2549227674/stm32-ai-safety-monitor/CROSS_FILE_CONSISTENCY_REPORT.md

# 跨文件一致性自检报告

生成时间：2026-06-04T18:26:44

## 1. 自检结果

| 项目 | 结果 | 说明 |
|---|---|---|
| 项目主标题一致 | 通过 | 已在 README/CANONICAL/docs/14 等文件使用统一主标题。 |
| 四层架构一致 | 通过 | 四层名称来自 canonical。 |
| Contract 字段齐全 | 通过 | docs/07 为权威来源。 |
| 不新增 docs/15 | 通过 | 仅 docs/00-14 + docs/migration。 |
| 预期文件存在 | 通过 | 全部存在。 |
| TODO 索引生成 | 通过 | 共汇总 37 条 TODO。 |

## 2. 已修正/控制的冲突

- 旧仓库中文文件名在 zip 中出现 `#U...` 转义，本包统一使用 canonical 新文件名。
- 旧 STM32/ESP32 代码与最新会话状态脱节，本包在 migration 文档中写实说明，不把旧链路写成通过。
- Flask 后端不推倒重写，所有文档统一要求“保留并扩展”。
- `docs/07` 被指定为 Contract 权威来源，其他文档只引用，不另造字段。

## 3. 仍需本地执行的事项

详见 `CLAUDE_CODE_TODO_INDEX.md`。重点优先级：DECIDE/FILL 类先处理，随后执行 Task01–08。
