2549227674/stm32-ai-safety-monitor/tests/opi5/2026-06-10_opi5_real_hardware_regression.md

# OPi5 真实设备回归测试

## 1. 测试环境

| 项目 | 值 |
|---|---|
| 日期 | 2026-06-10 / 2026-06-11 |
| 分支 | migration/imx6ull-opi5-edge-ai |
| commit | f5f02b4 |
| OPi5 IP | 10.96.98.38 (WiFi) |
| WSL/Backend IP | 10.96.98.103 |
| OPi5 Python | 3.10.12 |
| OPi5 OS | Linux orangepi5 6.1.99-rockchip-rk3588 aarch64 |
| WSL Python | 3.12.3 |
| Node.js | v22.21.0 |
| USB camera | Y Media Corp. USB Camera (Bus 003), /dev/video0 |
| Qwen3-VL | PASS (running, model_ready=true, qwen3-vl-2b rknn-llm) |
| SMTP | PASS (smtp.qq.com, test email sent successfully) |

## 2. 接线核对

来源：`docs/reference/hardware/opi5_pinmap_current.md`、`docs/reference/hardware/opi5_current_hardware_wiring.md`、`edge/opi5-controller/src/opi5_safetyd.c`

| 信号 | OPi5 脚 | GPIO | 方向 | 有效电平 | 文档一致 | 代码一致 | GPIO readall | 结果 |
|---|---|---|---|---|---|---|---|---|
| I2C5 SDA | pin 3 | 47 | I2C (ALT9) | OLED + MPU6050 | ✓ | ✓ | SDA.5 ALT9 V=1 | PASS |
| I2C5 SCL | pin 5 | 46 | I2C (ALT9) | OLED + MPU6050 | ✓ | ✓ | SCL.5 ALT9 V=1 | PASS |
| Pan servo | pin 7 | 54/PWM15 | PWM | 50Hz pwmchip4 | ✓ | ✓ | PWM15 IN V=1 | PASS |
| Water MOS | pin 11 | 138 | output | active HIGH | ✓ | ✓ | CAN1_RX IN V=1 | PASS |
| PIR | pin 13 | 139 | input | active HIGH | ✓ | ✓ | CAN1_TX IN V=1 | PASS |
| Flame | pin 15 | 28 | input | active LOW | ✓ | ✓ | CAN2_RX IN V=1 | PASS |
| MQ-2 | pin 19 | 49 | input | active LOW | ✓ | ✓ | SPI4_TXD IN V=1 | PASS |
| RGB R | pin 21 | 48 | output | active HIGH | ✓ | ✓ | SPI4_RXD IN V=1 | PASS |
| RGB G | pin 23 | 50 | output | active HIGH | ✓ | ✓ | SPI4_CLK IN V=1 | PASS |
| RGB B | pin 24 | 52 | output | active HIGH | ✓ | ✓ | SPI4_CS1 IN V=1 | PASS |
| Buzzer | pin 26 | 35 | output | active LOW | ✓ | ✓ | PWM1 IN V=1 | PASS |

> GPIO readall 输出中 Mode=IN 表示引脚未被用户程序 export，安全闭环程序启动后会自动 export 并设为正确方向。

物理接线确认（通过 GPIO 实测推断）：

- [x] OPi5 USB-C 供电正常（uptime 29min+, temp 37°C）
- [x] I2C5 引脚已配置为 ALT9 模式
- [x] USB 摄像头已接（lsusb 可见）
- [x] PIR / Flame / MQ-2 输入 GPIO 可读取（见 Step 4）
- [x] RGB / Buzzer / Water MOS 输出 GPIO 可写入（见 Step 5）
- [ ] OLED SDA/SCL 接 pin3/pin5 — I2C5 扫描未见 0x3C（见问题 #1）
- [ ] MPU6050 SDA/SCL 接 pin3/pin5 — I2C5 扫描未见 0x68（见问题 #1）
- [x] Pan 舵机信号接 pin7 — PWM 输出成功

## 3. I2C/USB/GPIO 发现

### gpio readall

```
 +------+-----+----------+--------+---+   OPI5   +---+--------+----------+-----+------+
 | GPIO | wPi |   Name   |  Mode  | V | Physical | V |  Mode  | Name     | wPi | GPIO |
 +------+-----+----------+--------+---+----++----+---+--------+----------+-----+------+
 |      |     |     3.3V |        |   |  1 || 2  |   |        | 5V       |     |      |
 |   47 |   0 |    SDA.5 |   ALT9 | 1 |  3 || 4  |   |        | 5V       |     |      |
 |   46 |   1 |    SCL.5 |   ALT9 | 1 |  5 || 6  |   |        | GND      |     |      |
 |   54 |   2 |    PWM15 |     IN | 1 |  7 || 8  | 0 | IN     | RXD.0    | 3   | 131  |
 |      |     |      GND |        |   |  9 || 10 | 0 | IN     | TXD.0    | 4   | 132  |
 |  138 |   5 |  CAN1_RX |     IN | 1 | 11 || 12 | 1 | IN     | CAN2_TX  | 6   | 29   |
 |  139 |   7 |  CAN1_TX |     IN | 1 | 13 || 14 |   |        | GND      |     |      |
 |   28 |   8 |  CAN2_RX |     IN | 1 | 15 || 16 | 1 | ALT9   | SDA.1    | 9   | 59   |
 |      |     |     3.3V |        |   | 17 || 18 | 1 | ALT9   | SCL.1    | 10  | 58   |
 |   49 |  11 | SPI4_TXD |     IN | 1 | 19 || 20 |   |        | GND      |     |      |
 |   48 |  12 | SPI4_RXD |     IN | 1 | 21 || 22 | 1 | IN     | GPIO2_D4 | 13  | 92   |
 |   50 |  14 | SPI4_CLK |     IN | 1 | 23 || 24 | 1 | IN     | SPI4_CS1 | 15  | 52   |
 |      |     |      GND |        |   | 25 || 26 | 1 | IN     | PWM1     | 16  | 35   |
 +------+-----+----------+--------+---+----++----+---+--------+----------+-----+------+
```

### i2cdetect -y 5

```
     0  1  2  3  4  5  6  7  8  9  a  b  c  d  e  f
00:                         -- -- -- -- -- -- -- --
...
70: -- -- -- -- -- -- -- --
```

**I2C5 完全为空** — 未发现 OLED (0x3C) 和 MPU6050 (0x68)。扫描了所有总线（0/1/2/5/6/7/9/10），均未见 0x3C 或 0x68。

### lsusb

```
Bus 003 Device 002: ID 0bdc:8088 Y Media Corp. USB Camera
Bus 005 Device 002: ID 0bda:0179 Realtek Semiconductor Corp. RTL8188ETV Wireless LAN
```

USB 摄像头已识别 ✓

### v4l2-ctl

```
USB Camera: USB Camera (usb-fc800000.usb-1):
    /dev/video0
    /dev/video1
    /dev/media0

[0]: 'MJPG' (Motion-JPEG, compressed)
    Size: Discrete 1280x720 @ 30fps
    Size: Discrete 640x480 @ 30fps
```

摄像头支持 MJPG，1280x720@30fps ✓

### USB 摄像头抓帧

```
v4l2-ctl -d /dev/video0 --set-fmt-video=width=640,height=480,pixelformat=MJPG \
  --stream-mmap=3 --stream-count=1 --stream-to=/tmp/test_capture.jpg
-rw-r--r-- 1 root root 7096 Jun 10 23:59 /tmp/test_capture.jpg
```

抓帧成功，7096 bytes ✓

## 4. 输入传感器测试

### PIR / GPIO139 / pin13 / active HIGH

```
echo 139 > /sys/class/gpio/export
echo in > /sys/class/gpio/gpio139/direction
cat /sys/class/gpio/gpio139/value
→ 1
```

- raw=1, active HIGH → pir=1（触发状态，可能有人经过或 PIR 模块默认 HIGH）
- **结果：PASS**（GPIO 可读，电平逻辑正确）

### Flame / GPIO28 / pin15 / active LOW

```
echo 28 > /sys/class/gpio/export
cat /sys/class/gpio/gpio28/value
→ 1
```

- raw=1, active LOW → flame=0（无火焰）✓
- **结果：PASS**

### MQ-2 / GPIO49 / pin19 / active LOW

```
echo 49 > /sys/class/gpio/export
cat /sys/class/gpio/gpio49/value
→ 1
```

- raw=1, active LOW → mq2=0（无烟雾）✓
- **结果：PASS**
- 备注：DO 电平需万用表确认 ≤3.3V（未做，需人工确认）

## 5. 输出执行器测试

### RGB R / GPIO48 / pin21 / active HIGH

```
echo out > /sys/class/gpio/gpio48/direction
echo 1 > /sys/class/gpio/gpio48/value
cat /sys/class/gpio/gpio48/value → 1
echo 0 > /sys/class/gpio/gpio48/value
```

- **结果：PASS**（写 1 读 1，写 0 关闭）

### RGB G / GPIO50 / pin23 / active HIGH

- 写 1 读 1 ✓
- **结果：PASS**

### RGB B / GPIO52 / pin24 / active HIGH

- 写 1 读 1 ✓
- **结果：PASS**

### Buzzer / GPIO35 / pin26 / active LOW

```
echo out > /sys/class/gpio/gpio35/direction
echo 1 > /sys/class/gpio/gpio35/value   → 不响（active LOW 默认关闭）
echo 0 > /sys/class/gpio/gpio35/value   → 响（active LOW 触发）
echo 1 > /sys/class/gpio/gpio35/value   → 恢复不响
```

- 默认 1 = 不响 ✓
- 触发 0 = 响 ✓
- **结果：PASS**

### Water MOS / GPIO138 / pin11 / active HIGH

```
echo out > /sys/class/gpio/gpio138/direction
echo 0 > /sys/class/gpio/gpio138/value   → off（默认关闭）
echo 1 > /sys/class/gpio/gpio138/value   → on
cat → 1
echo 0 > /sys/class/gpio/gpio138/value   → off
```

- 默认 0 = 关闭 ✓
- 触发 1 = 导通 ✓
- 未接真实水泵负载（空载测试）
- **结果：PASS（空载）**

### Pan servo / PWM15 / pin7 / pwmchip4

```
echo 0 > /sys/class/pwm/pwmchip4/export
echo 20000000 > /sys/class/pwm/pwmchip4/pwm0/period     # 50Hz
echo 1500000 > /sys/class/pwm/pwmchip4/pwm0/duty_cycle   # 中位 90°
echo 1 > /sys/class/pwm/pwmchip4/pwm0/enable
# period=20000000, duty_cycle=1500000, enable=1

echo 1100000 > /sys/class/pwm/pwmchip4/pwm0/duty_cycle   # 80°
echo 1500000 > /sys/class/pwm/pwmchip4/pwm0/duty_cycle   # 回中 90°

echo 0 > /sys/class/pwm/pwmchip4/pwm0/enable
echo 0 > /sys/class/pwm/pwmchip4/unexport
```

- pwmchip4 存在 ✓
- pwm0 导出成功 ✓
- 50Hz period 设置成功 ✓
- 80° / 90° 动作成功 ✓
- 清理成功 ✓
- **结果：PASS**（需观察实际舵机是否物理转动）

## 6. safetyd 本地闭环

### 编译验证

在 OPi5 上原生编译：

```
gcc -Wall -Wextra -Wno-format-truncation -O2 -Iinclude src/bsp_oled_ssd1306.c src/opi5_safetyd.c -o opi5_safetyd
-rwxrwxr-x 1 orangepi orangepi 57896 Jun 11 00:00 opi5_safetyd
```

**编译：PASS**（OPi5 上 gcc 11.4.0 aarch64）

### 运行验证（once 模式）

```
sudo ./opi5_safetyd --mode once --post-normal 1 --base-dir /tmp/safetyd-test

[2026-06-10T16:01:07Z] [actuators] all_off (backend=gpio)
[2026-06-10T16:01:07Z] [start] mode=once device_id=labbox_001 base_dir=/tmp/safetyd-test oled=disabled
[2026-06-10T16:01:08Z] [gpio] gpio139 raw=1 pir=1 | gpio28 flame_raw=1 flame=0 | gpio49 mq2_raw=1 mq2=0
[2026-06-10T16:01:08Z] [soc_temp] valid=1 temp=37.0C warn=70C device_health=NORMAL
[2026-06-10T16:01:08Z] [state] VERIFY risk_before_ai=2 need_snap=true
[2026-06-10T16:01:08Z] [actuators] state=VERIFY buzzer=0 R=0 G=0 B=1 relay=0 pump=0 rgb_backend=gpio
[2026-06-10T16:01:08Z] [capture] /dev/video0 -> .../safetyd_9001.jpg
[2026-06-10T16:01:28Z] [ai] HTTP 200, risk_hint=2, control_allowed=false
[2026-06-10T16:01:28Z] [flask] HTTP 000 spooled
[2026-06-10T16:01:28Z] [summary] seq=9001 state=VERIFY risk_score=4 ai_status=ok backend_status=spooled
[2026-06-10T16:01:28Z] [actuators] all_off (backend=gpio)
```

Status JSON:

```json
{
  "program": "opi5_safetyd_c",
  "last_seq": 9001,
  "last_state": "VERIFY",
  "last_pir": 1,
  "last_flame": 0,
  "last_mq2": 0,
  "last_risk_score": 4,
  "soc_temp": 37.0,
  "device_health": "NORMAL",
  "last_ai_status": "ok",
  "last_backend_status": "spooled",
  "last_error": null
}
```

验证项：

| 项目 | 结果 | 详情 |
|---|---|---|
| all_off 启动清理 | PASS | 启动和退出时 all_off |
| GPIO 读取 | PASS | PIR=1, Flame=0, MQ-2=0 |
| SoC 温度 | PASS | 37.0°C, device_health=NORMAL |
| 状态计算 | PASS | PIR→VERIFY (risk=2) |
| 执行器响应 | PASS | VERIFY→蓝灯 (B=1), 其余 OFF |
| 摄像头抓帧 | PASS | /dev/video0 抓帧成功 |
| AI 推理 | PASS | HTTP 200, risk_hint=2, control_allowed=false |
| risk_score 合成 | PASS | 2(local) + 2(AI) = 4 |
| Backend spool | PASS | HTTP 000→spooled（Flask 未启动，预期行为） |
| 退出清理 | PASS | all_off 清理 |

**结果：PASS**

## 7. device-agent

### Mock 模式（WSL 测试）

| 端点 | 结果 | 详情 |
|---|---|---|
| GET /health | PASS | `{"ok":true, "device_id":"edge-opi5-001"}` |
| GET /api/status | PASS | camera_status=mock, video_mode=mock, video_available=true |
| HEAD /api/video/snapshot.jpg | PASS | 200 OK, image/jpeg, 18341 bytes |
| HEAD /api/video/stream | PASS | 200 OK, multipart/x-mixed-replace |

### 真实摄像头（OPi5 测试）

| 端点 | 结果 | 详情 |
|---|---|---|
| GET /health | PASS | `{"ok":true, "service":"opi5-device-agent"}` |
| GET /api/status | PASS | video_available=true, ip=10.96.98.38 |
| GET /api/video/snapshot.jpg | PASS | 200 OK, image/jpeg, 50972 bytes（真实摄像头，比 mock 大 3x） |
| GET /api/video/stream | PASS | 200 OK, multipart/x-mixed-replace |

> 注意：OPi5 上的 device-agent 版本缺少 `camera_status`、`video_mode`、`camera` 字段（见问题 #2）。

### 端到端视频代理（OPi5 → WSL Flask → 浏览器）

| 端点 | 结果 | 详情 |
|---|---|---|
| GET /api/video/snapshot.jpg?device_id=edge-opi5-001 | PASS | 200 OK, image/jpeg, 50393 bytes |
| GET /api/video/stream?device_id=edge-opi5-001 | PASS | 200 OK, multipart/x-mixed-replace |

Flask 通过 agent_url (http://10.96.98.38:8090) 代理视频流到浏览器 ✓

## 8. Flask API

| 端点 | 结果 | 详情 |
|---|---|---|
| GET /health | PASS | `{"ok":true, "service":"safety-monitor-backend", "version":"0.1.0"}` |
| GET /api/devices | PASS | edge-opi5-001 online=true |
| GET /api/telemetry/series?metric=cpu_temp_c | PASS | alias→device.cpu_temp_c |
| GET /api/telemetry/series?metric=mpu6500_vibration | PASS | alias→mpu6500.vibration_score |
| GET /api/telemetry/series?metric=pir | PASS | alias→safety.pir |
| GET /api/video/snapshot.jpg | PASS | 代理到 OPi5 device-agent，JPEG 50393 bytes |
| GET /api/video/stream | PASS | 代理到 OPi5 device-agent，multipart stream |
| GET /api/notification/settings | PASS | enabled=true, configured=true |
| GET /api/notification/logs | PASS | 含 dedupe_key 字段 |
| GET /api/ai/observations/latest | PASS | control_allowed=false |

### 端到端心跳

OPi5 device-agent → WSL Flask heartbeat：

```
device_id: edge-opi5-001
ip: 10.96.98.38
online: true
AI: qwen3-vl-2b, model_ready=true
```

**结果：PASS**

## 9. 前端 Dashboard

### 构建验证

```
vite v8.0.16 building client environment for production...
✓ 28 modules transformed.
../backend/static/edge-console/assets/index.js   280.03 kB (gzip: 85.79 kB)
✓ built in 145ms
```

**前端构建：PASS**

### 前端访问地址

```
http://10.96.98.103:5000/
```

### 浏览器功能检查

- [ ] 设备列表在线
- [ ] 视频区域显示真实摄像头画面
- [ ] telemetry 曲线有 risk / cpu_temp / vib
- [ ] AI 页面显示最新 observation
- [ ] 通知设置页能打开
- [ ] Dashboard 不出现 i.MX / PCA9685 / BH1750

**结果：构建 PASS；浏览器功能待人工验证**

## 10. 邮件通知

| 测试项 | 结果 | 详情 |
|---|---|---|
| SMTP 配置 | PASS | smtp.qq.com:465 SSL, 已持久化到 notification_config.json |
| POST /api/notification/test-email | PASS | ok=true, status="sent" |
| GET /api/notification/logs | PASS | dedupe_key 字段存在 |
| notification_config.json | .gitignore | 已在 .gitignore 中 |

**结果：PASS**

## 11. 问题列表

| # | 问题 | 严重级别 | 现象 | 可能原因 | 下一步 |
|---|---|---|---|---|---|
| 1 | I2C5 无设备 | **P1** | i2cdetect -y 5 全空，扫描所有总线均未见 0x3C/0x68 | OLED/MPU6050 未接线、未供电、或接错总线 | 检查 I2C 模块接线和供电，确认 SDA/SCL 是否接到 pin3/pin5 |
| 2 | OPi5 device-agent 缺少 camera 字段 | P2 | /api/status 无 camera_status/video_mode/camera 字段 | OPi5 上部署的 device-agent 版本比仓库旧 | 重新部署 edge/opi5-device-agent 到 OPi5 |
| 3 | PIR 默认 HIGH | P3 | 无人时 raw=1 | PIR 模块默认行为或灵敏度设置 | 需人工确认 PIR 在无人静止状态下是否为 0 |
| 4 | MQ-2 DO 电平未验证 | P3 | 未用万用表测量 | 需人工 | 万用表测量 MQ-2 DO 引脚电压 ≤3.3V |
| 5 | Water MOS 未接真实负载 | P3 | 空载测试通过 | 安全起见 | 阶段 1 通过后可接低压负载测试 |
| 6 | 前端浏览器未验证 | P3 | 需要浏览器 | 需人工 | 打开 http://10.96.98.103:5000/ |
| 7 | telemetry batch 400 | P3 | Flask 日志显示多次 400 | device-agent 发送的 batch 格式可能不匹配 | 检查 device-agent batch payload 格式 |

## 12. 结论

**总体结论：PARTIAL (大部分 PASS)**

已完成（PASS）：

- [x] 仓库状态确认
- [x] Python 代码编译检查（backend + device-agent + seed script）
- [x] opi5_safetyd OPi5 原生编译（gcc 11.4.0 aarch64）
- [x] 前端 npm build
- [x] 静态接线核对（文档 vs 代码 一致）
- [x] GPIO readall / lsusb / v4l2-ctl 发现
- [x] 输入传感器 GPIO 读取（PIR/Flame/MQ-2）
- [x] 输出执行器 GPIO 写入（RGB R/G/B, Buzzer, Water MOS）
- [x] PWM 舵机输出（pwmchip4, 50Hz, 80-90°）
- [x] USB 摄像头抓帧（/dev/video0, MJPG 640x480）
- [x] opi5_safetyd 本地闭环运行（VERIFY 状态, AI 推理, 控制器执行器）
- [x] device-agent mock + 真实摄像头模式
- [x] Flask API 全端点验证
- [x] 端到端视频代理（OPi5 → WSL Flask → 浏览器）
- [x] 端到端心跳（OPi5 → WSL Flask）
- [x] 邮件通知 SMTP 发送

待修复/确认：

- [ ] I2C5 设备扫描失败（OLED + MPU6050）
- [ ] OPi5 device-agent 版本更新
- [ ] PIR 默认状态确认
- [ ] MQ-2 DO 电平万用表确认
- [ ] 前端浏览器功能人工验证
- [ ] telemetry batch 400 错误排查

**I2C5 问题为 P1 阻塞项**，其余为 P2/P3 可后续修复。软件栈和 GPIO 闭环已验证通过，可进入报告证据包收口（I2C 部分标注待修复）。
