2549227674/stm32-ai-safety-monitor/CLAUDE_CODE_TASK_02_wsl_imx6ull_toolchain_ssh.md

# Archived

This task belongs to the historical i.MX6ULL stage and is no longer part of the current OPi5 demo mainline.

Current entry: see `CLAUDE_CODE_TASK_DOCS_OPI5_ALIGNMENT.md` and `CANONICAL_DECISIONS.md`.
Archive: `docs/archive/2026-imx6ull-stage/tasks/CLAUDE_CODE_TASK_02_wsl_imx6ull_toolchain_ssh.md`
