2549227674/stm32-ai-safety-monitor/docs/03_硬件系统设计与供电安全_OPi5版.md

# 03 硬件系统设计与供电安全（OPi5 版）

## 3.1 当前硬件口径

OPi5 是唯一主控。图 1 为 OPi5 26pin 接口 + 供电拓扑，图 2 为 OPi5 引脚到模块的实际接线。

当前正式接线不包含：i.MX6ULL、STM32、ESP32-CAM、PCA9685、Tilt 舵机、继电器、风扇、P1 水泵。

## 3.2 当前模块清单

| 模块 | 用途 | 状态 |
|---|---|---|
| Orange Pi 5 16GB + 128G NVMe | 主控 + AI 推理 | 当前主线 |
| USB 摄像头 | 图像采集 | 当前主线 |
| PIR 人体红外 | 运动检测 | 当前主线 |
| 火焰传感器 | 火焰检测 | 当前主线 |
| MQ-2 烟雾传感器 | 烟雾/气体检测 | 当前主线 |
| RGB LED + 220Ω | 状态指示灯 | 当前主线 |
| 有源蜂鸣器 + NPN | 声音报警 | 当前主线 |
| Water MOS 模块 | 低压喷淋开关 | 当前主线 |
| MG90 单轴 Pan 舵机 | 摄像头水平扫描 | 当前主线 |
| OLED SSD1306 0.96" | 本地状态屏 | 当前主线 |
| MPU6050 | 可选振动监测 | 当前主线 |
| DHT11 | 未来外置 MCU 预留 / mock | 仅 mock |

## 3.3 OPi5 26pin 引脚分配

```text
I2C1 SDA       pin16 gpio59   OLED 0x3C + MPU6050 0x68
I2C1 SCL       pin18 gpio58   OLED 0x3C + MPU6050 0x68
Pan servo      pin7  gpio54/PWM15
Water MOS      pin11 gpio138 active HIGH
PIR            pin13 gpio139 active HIGH
Flame          pin15 gpio28  active LOW
MQ-2           pin19 gpio49  active LOW
RGB-R          pin21 gpio48  active HIGH
RGB-G          pin23 gpio50  active HIGH
RGB-B          pin24 gpio52  active HIGH
Buzzer         pin26 gpio35  active LOW
```

## 3.4 供电拓扑与 GND_STAR

```text
12V 输入（适配器/电池）
  ├─ DC-DC 5V/4A~5A  → OPi5 USB-C
  ├─ DC-DC 5V~6V/3A  → 舵机 5V（独立供电）
  ├─ 负载 5V          → Water MOS 负载
  └─ GND 星形共地     → OPi5 / MOS / 负载 / 传感器
```

- 传感器供电：3.3V 从 OPi5 引脚取
- 舵机供电：独立 5V~6V DC-DC，不从 OPi5 取
- MOS 负载：独立 5V，不从 OPi5 取
- 所有模块共地，星形拓扑

## 3.5 输入传感器

| 信号 | 引脚 | 有效电平 | 供电 | 说明 |
|---|---|---|---|---|
| PIR | pin13 / gpio139 | active HIGH | 3.3V（模块自带） | 人体红外 |
| Flame | pin15 / gpio28 | active LOW | 3.3V | 火焰数字 DO |
| MQ-2 | pin19 / gpio49 | active LOW | 5V（加热丝） | 烟雾数字 DO |

> MQ-2 供电 5V，DO 输出经分压或直接接入 OPi5 GPIO（OPi5 GPIO 为 3.3V tolerant，MQ-2 模块 DO 输出通常为 3.3V 逻辑电平）。

## 3.6 I2C 设备

| 设备 | 地址 | 总线 | 说明 |
|---|---|---|---|
| OLED SSD1306 | 0x3C | I2C1 (pin16/pin18) | 状态屏 |
| MPU6050 | 0x68 | I2C1 (pin16/pin18) | 可选振动监测 |

## 3.7 输出设备

| 输出 | 引脚 | 驱动 | 有效电平 | 默认态 |
|---|---|---|---|---|
| RGB-R | pin21 / gpio48 | GPIO + 220Ω 限流 | active HIGH | OFF |
| RGB-G | pin23 / gpio50 | GPIO + 220Ω 限流 | active HIGH | OFF |
| RGB-B | pin24 / gpio52 | GPIO + 220Ω 限流 | active HIGH | OFF |
| Buzzer | pin26 / gpio35 | NPN 三极管 + 1k 基极 | active LOW | OFF (gpio=1) |
| Water MOS | pin11 / gpio138 | MOS 模块 | active HIGH | OFF |
| Pan servo | pin7 / PWM15 | PWM 50Hz | 脉宽控制 | 90° 中位 |

## 3.8 摄像头

USB 摄像头接入 OPi5 USB 口。由 `opi5-device-agent` 提供 MJPEG 视频流（`/api/video/stream`）和快照（`/api/video/snapshot.jpg`）。摄像头不可用时 device-agent 自动回退到 mock 模式。

## 3.9 不再使用的模块

以下模块属于历史阶段，不在当前 OPi5 主线接线中：

| 模块 | 历史阶段 | 说明 |
|---|---|---|
| i.MX6ULL Pro | 第二版双板架构 | 供电/启动异常，已迁移 |
| STM32 + ESP32-CAM | 第一版端云架构 | 已归档 |
| PCA9685 16路 PWM | 第二版 i.MX 控制 | 4 个模块均未 ACK，已弃用 |
| Tilt 舵机 | 第二版二维云台 | 当前仅用单轴 Pan |
| 继电器模块 | 第二版 P1 扩展 | 不在当前接线 |
| 风扇 | 第二版 P1 扩展 | 不在当前接线 |
| P1 水泵 | 第二版 P1 扩展 | 当前用 Water MOS 替代 |

## 3.10 安全边界

1. 低压直流供电，不接 220V
2. 星形共地，避免地环路
3. 执行器上电默认 OFF
4. AI 服务 / Flask / 前端不控制执行器；只有 OPi5 本地 `opi5_safetyd` 控制执行器
5. `control_allowed=false` 硬编码
