2549227674/stm32-ai-safety-monitor/docs/11_测试计划与风险矩阵_端边协同版.md

# 11 测试计划与风险矩阵（OPi5 主线版）

## 11.1 测试原则

1. 先单模块，后集成。
2. 先空载，后接负载。
3. 先 mock，后真实。
4. 未实测不写通过。
5. 每项测试都要有命令、现象、结果、证据路径。

## 11.2 编译与语法检查

| 测试 | 命令 | 说明 |
|---|---|---|
| backend py_compile | `python -m py_compile server/backend/*.py` | Flask 后端语法 |
| device-agent py_compile | `python -m py_compile edge/opi5-device-agent/*.py` | 设备代理语法 |
| seed script | `python -m py_compile scripts/seed_frontend_mock_data.py` | mock 数据脚本语法 |
| frontend build | `cd server/frontend && npm run build` | React 构建 |

## 11.3 Flask API 测试

| 测试 | 方法 | 说明 |
|---|---|---|
| `/health` | `curl` | 服务健康检查 |
| `POST /api/events` | `curl` | 旧事件兼容 |
| `GET /api/events` | `curl` | 事件列表 |
| `GET /api/status/latest` | `curl` | 最新状态 |
| `POST /api/devices/heartbeat` | `curl` | 设备心跳 |
| `GET /api/devices` | `curl` | 设备列表 |
| `POST /api/telemetry/batch` | `curl` | 遥测批量上报 |
| `GET /api/telemetry/series` | `curl` | 遥测时序查询 |
| `POST /api/ai/observations` | `curl` | AI observation |
| `GET /api/ai/observations/latest` | `curl` | 最新 AI observation |
| `GET/PUT /api/notification/settings` | `curl` | 通知配置 |
| `POST /api/notification/test-email` | `curl` | 测试邮件 |
| `GET /api/notification/logs` | `curl` | 通知日志 |

## 11.4 mock 数据与 seed 脚本

| 测试 | 方法 | 说明 |
|---|---|---|
| seed mock 数据 | `python scripts/seed_frontend_mock_data.py` | 向 Flask 注入 mock 事件/遥测/AI |
| no-device 状态 | 不发送心跳 | Dashboard 显示设备离线 |
| mock 视频 | device-agent `MOCK_SENSORS=1` | 视频流标注 MOCK |

## 11.5 前端构建与展示

| 测试 | 方法 | 说明 |
|---|---|---|
| npm build | `npm run build` | 构建无报错 |
| Dashboard 可访问 | 浏览器打开 | 多页面可导航 |
| 设备离线状态 | 不启动 device-agent | Dashboard 显示无设备 |
| mock 数据展示 | seed 后刷新 | 事件/遥测/AI 数据可见 |

## 11.6 device-agent 测试

| 测试 | 方法 | 说明 |
|---|---|---|
| `/health` | `curl` | 服务健康 |
| `/api/status` | `curl` | 设备状态 |
| `/api/video/stream` | `curl` / 浏览器 | MJPEG 流（mock） |
| `/api/video/snapshot.jpg` | `curl` | 快照（mock） |
| 心跳上报 | 观察 Flask `/api/devices` | 5s 周期 |
| 遥测上报 | 观察 Flask `/api/telemetry/series` | 30s 批量 |
| AI observation | 观察 Flask `/api/ai/observations` | 30s 周期 |

## 11.7 通知测试

| 测试 | 方法 | 说明 |
|---|---|---|
| 通知配置持久化 | PUT settings 后重启 | 配置保留 |
| 测试邮件 | POST test-email | 实际发送 |
| 通知日志 | GET logs | 记录可见 |

## 11.8 视频代理测试

| 测试 | 方法 | 说明 |
|---|---|---|
| mock 视频代理 | Flask `/api/video/stream` | 返回 mock 流 |
| 设备离线 503 | 不启动 device-agent | Flask 返回 503 |
| 快照代理 | Flask `/api/video/snapshot.jpg` | 返回 JPEG |

## 11.9 真实硬件测试（仅当硬件可用时）

| 测试 | 方法 | 说明 |
|---|---|---|
| PIR 触发 | 人体靠近 | pir=1，状态变化 |
| 火焰触发 | 打火机靠近 | flame=1 → ALARM |
| MQ-2 触发 | 烟雾靠近 | mq2=1 → ALARM |
| 蜂鸣器响应 | ALARM 状态 | 蜂鸣器响 |
| RGB 状态灯 | 各状态 | 颜色正确 |
| Water MOS | ALARM 状态 | MOS 导通 |
| Pan 舵机 | 巡检扫描 | 三点平滑 |
| USB 摄像头 | 真实视频流 | MJPEG 正常 |
| AI 推理 | Qwen3-VL | 返回真实结果 |

## 11.10 风险矩阵

| 风险 | 概率 | 影响 | 应对 |
|---|---|---|---|
| 摄像头不兼容 | 中 | 中 | mock 回退，降低分辨率 |
| AI 模型加载慢 | 中 | 低 | 持久化进程，启动预热 |
| 供电不稳 | 中 | 高 | 多路 DC-DC，舵机独立供电 |
| Dashboard schema 破坏 | 低 | 中 | `raw_json` 兼容，增量迁移 |
| email 配置失效 | 低 | 低 | mock 通知日志回退 |

## 11.11 答辩前检查清单

- [ ] Dashboard 可打开，多页面可导航
- [ ] 至少一条 mock 事件可展示
- [ ] 至少一个 AI observation 可展示
- [ ] 通知设置可配置，测试邮件可发送
- [ ] AI JSON 中 `control_allowed=false`
- [ ] 设备离线状态可展示
- [ ] mock/真实模式切换正常

## 11.12 历史 i.MX 测试索引

历史 i.MX6ULL 阶段的测试记录保留在 `tests/imx6ull/` 和 `tests/integration/` 中，包括 GPIO 输入、PCA9685 PWM、V4L2 抓拍、端边联调等。详见 `docs/archive/2026-imx6ull-stage/`。
