2549227674/stm32-ai-safety-monitor/legacy/2026-stm32-esp32/stm32/README.md

# STM32 固件开发说明

## 开发环境

- MCU：STM32F103C8T6
- 工具链：STM32CubeMX + Keil MDK-ARM
- 固件库：STM32 HAL 库
- 调试下载：ST-Link
- 调度方式：裸机前后台 + SysTick 定时调度

不使用 STM32F10x 标准外设库，不混用标准库和 HAL，不引入 FreeRTOS。CubeMX 生成文件中的自定义代码必须写在 `USER CODE BEGIN` / `USER CODE END` 区域。

`.c/.h` 源码注释建议使用英文，避免 Keil 中文注释显示为 `???`；README 和 docs 文档继续使用中文。

## 当前真实进度

| 编号 | 任务 | 状态 | 备注 |
|---|---|---|---|
| P0-00 | STM32 最小工程 + PC13 LED 闪烁 | 已完成 | CubeMX + Keil + HAL + ST-Link 跑通；HSE 8MHz + PLL x9，SYSCLK 72MHz；PA13/PA14 保留 SWD |
| P0-01 | USART1 串口日志输出 | 暂缓 | USB-TTL 未到货；计划使用 PA9/PA10；当前依赖 PC13 LED 和 Keil Debug Watch |
| P0-02 | AD 四位按键输入验证 | 已完成 | AD 接 PA0/ADC1_IN0；ADC1 软件触发、单通道、轮询读取；K1-K4 阈值已实测 |
| P0-03 | 蜂鸣器 / RGB LED 输出验证 | 已完成 | PB5 蜂鸣器低电平触发；PB0/PB1/PB10 分别控制 RGB R/G/B |
| P0-04A-1 | OLED 固定文本显示 | 已完成 | I2C1 PB6/PB7，地址 0x3C |
| P0-04A-2 | OLED 实时调试页面 | 已完成 | 显示 KEY ADC、KEY ID、FLAME、PIR、MQ2、STATE |
| P0-04B-0 | 火焰传感器 DO 输入 | 部分完成 | PB12 / FLAME_DO；无火焰状态显示正常，真实触发待安全补测 |
| P0-04B-1 | PIR HC-SR501 输入 | 已完成 | PB15 / PIR_DO 已通过；PB13 原方案输入链路不可靠，不再作为 PIR 默认引脚 |
| P0-04B-2 | MQ-2 DO 输入 | 软件链路通过，实物暂缓 | PB14 / MQ2_DO 模拟通过；MQ-2 实物 DO/AO 待 10k/20k 分压电阻 |
| P0-04B-3 | MQ-2 AO 输入 | 未开始 | 后续 PA1 / ADC1_IN1；5V 供电时必须分压 |
| P0-05 | 继电器 / 风扇 / 水泵低压驱动 | 未开始 | 需外部电源和 MOS/驱动模块 |
| P0-06 | risk_score 风险评分 | 未开始 | 待输入输出链路稳定后实现 |
| P0-07 | safety_fsm 状态机 | 未开始 | 待 risk_score |
| P0-08 | 按键功能映射 | 未开始 | P0-02 仅完成 AD 按键识别 |
| P0-09 | P0 本地闭环整体验收 | 未开始 | 不依赖 ESP32-CAM/Web/服务器/AI |
| Stage 5 / Task 04 | USART1 → ESP32-CAM UART 桥接 | 代码已准备，待联调 | PA9=USART1_TX、PA10=USART1_RX，115200 8N1；当前只发送固定 `STM32_TEST` JSON；PA2/USART2 因逻辑分析仪未得到稳定 UART 波形，阶段 5 暂时放弃 |

当前 P0 阶段使用面包板分配 3.3V/5V 分轨并统一共地。ST-Link 3.3V 只适合 STM32 和少量小功耗模块临时 bring-up；MQ-2、ESP32-CAM、继电器、风扇、水泵不得从 ST-Link 3.3V 取电。若 STM32 已由手机 Type-C 充电器经核心板 Type-C 供电，则 ST-Link 只接 SWDIO/SWCLK/GND，不接 ST-Link 3.3V。12V 适配器/电池不得直接接 STM32、OLED、PIR、MQ-2。

## 当前 P0 OLED 模块

已新增：

```text
Core/Inc/bsp_oled.h
Core/Src/bsp_oled.c
Core/Inc/app_display.h
Core/Src/app_display.c
```

`bsp_oled` 是 SSD1306 OLED BSP 驱动，负责初始化、清屏、写字符、写字符串、刷新显示；使用 `I2C1`，`PB6=SCL`，`PB7=SDA`，地址 `0x3C`。

`app_display` 是 P0 调试显示页面，负责显示 `KEY ADC`、`KEY ID`、`FLAME`、`PIR`、`MQ2`、`STATE`。它不直接读取传感器，不直接控制执行器。

## Stage 5 / Task 04 UART 桥接代码

当前新增：

```text
Core/Inc/app_comm.h
Core/Src/app_comm.c
```

`app_comm` 只负责组装固定 `STM32_TEST` 事件 JSON，并通过 `USART1` 发送给 ESP32-CAM。每帧以 `\n` 结尾，第一版不读取 GPIO、不控制执行器、不实现 `risk_score` 或 `safety_fsm`，也不启用 DHT11。

USART1 配置由用户通过 CubeMX 生成：

```text
PA9  = USART1_TX
PA10 = USART1_RX
115200 8N1
```

PA2/USART2 在逻辑分析仪上未得到稳定 115200 UART 波形，阶段 5 暂时放弃。`main.c` 当前每 1 秒调用一次 `AppComm_SendStm32Test()`。Keil 编译前需要确认工程中已加入 `Core/Src/app_comm.c`。

最小接线：

```text
STM32 PA9 / USART1_TX -> ESP32-CAM U0R / RX / GPIO3
STM32 GND             <-> ESP32-CAM GND
ESP32-CAM 继续使用 USB 烧录底座供电
```

不要用 STM32 3.3V 或 ST-Link 3.3V 给 ESP32-CAM 供电。

当前 OLED 显示页面大致为：

```text
Safety Monitor
P0 Debug Page

KEY ADC:xxxx
KEY ID :NONE/K1/K2/K3/K4
FLAME  :0/1
PIR:0 MQ2:0
STATE  :IDLE/PIR/SMOKE/ALARM
```

## CubeMX 建工程步骤

1. 新建 CubeMX 工程，选择 `STM32F103C8T6`。
2. 配置系统时钟，优先使用 HSE；无外部晶振时使用 HSI。
3. `SYS` 调试接口选择 `Serial Wire`。
4. 配置 LED GPIO 为推挽输出。
5. 配置按键、门磁、PIR、火焰等 GPIO 输入，并设置 Pull-up 或 Pull-down，禁止浮空。
6. 配置 USART1 作为调试串口。
7. 配置 I2C 用于 OLED 和 MPU6050。
8. 配置 ADC 用于 MQ-2 AO。
9. 配置 TIM/PWM 用于蜂鸣器、RGB、风扇等输出。
10. Project Manager 中选择 Keil MDK-ARM 工程。
11. 生成代码后，只在 `USER CODE BEGIN` / `USER CODE END` 区域添加自定义代码。
12. 在 Keil 中编译、下载，先验证 LED 闪烁；USART1 日志待 USB-TTL 到货后补测。

引脚分配以 `docs/03_硬件系统设计与供电安全.md` 和 `firmware/stm32/docs/pinmap.md` 为准。本文件只记录阶段进度。

## 目录约定

- `Core/`：CubeMX 生成的启动、初始化和主文件。
- `BSP/`：对 HAL 外设接口做项目级封装，如 GPIO、ADC、I2C、USART、TIM/PWM。
- `Drivers/`：OLED、DHT、MQ-2、MPU6050、蜂鸣器、RGB 等设备驱动。
- `App/`：任务调度、传感器管理、风险评分、状态机、执行器联动、UI 和日志。
- `Protocol/`：STM32 与 ESP32-CAM 的 UART 帧协议。
- `Config/`：阈值、周期、引脚映射和功能开关。

## P0 最小验证顺序

1. LED：验证工程、时钟、HAL Tick 和主循环。已完成。
2. 串口：输出启动日志和周期心跳。暂缓，待 USB-TTL 到货。
3. 按键：AD 四位按键接 PA0/ADC1_IN0，验证短按和消抖。已完成输入识别。
4. 蜂鸣器/RGB：验证 PB5、PB0、PB1、PB10 输出。已完成。
5. OLED：已提前到 P0-04A，完成固定文本和实时调试页面。
6. 传感器：火焰 PB12 无火焰状态正常、PIR PB15 已通过、MQ-2 DO PB14 软件链路通过；MQ-2 实物和 AO 待分压电阻。
7. 执行器：P0-05 进入继电器/风扇/水泵低压驱动验证。
8. 状态机：后续接入风险评分、报警分级、声光和执行器联动。

## GPIO 输入要求

所有 GPIO 输入必须配置明确的 Pull-up 或 Pull-down，不能浮空。外部模块已带上拉/下拉时仍需在文档或代码注释中注明，避免误判输入电平。
