2549227674/stm32-ai-safety-monitor/docs/archive/2026-imx6ull-stage/hardware/README.md

# i.MX6ULL Stage - Hardware Archive

This directory originally contained i.MX6ULL hardware references.

## Current Hardware References

The current OPi5 hardware documentation is in:
- `docs/03_硬件系统设计与供电安全_OPi5版.md` — OPi5 wiring and power design
- `docs/reference/hardware/opi5_current_hardware_wiring.md` — OPi5 wiring diagram
- `docs/reference/hardware/opi5_pinmap_current.md` — OPi5 pinmap

## Historical i.MX6ULL Hardware

The i.MX6ULL hardware design is preserved in git history. Key references:
- i.MX6ULL J5 GPIO pinout (gpio117-124)
- PCA9685 I2C PWM (CH0-CH6)
- V4L2 USB camera on i.MX6ULL USB Host
- Dual-board network topology (i.MX6ULL ↔ OPi5)

See `docs/archive/2026-imx6ull-stage/tasks/` for the original task files with hardware details.
