2549227674/stm32-ai-safety-monitor/legacy/2026-stm32-esp32/stm32/docs/pinmap.md

# STM32 Pin Map

本文档记录当前已验证和预留引脚。未实际验证的引脚必须标注为“预留”或“待验证”，避免后续误认为已经完成。

## 已验证 / 部分验证引脚

| 引脚 | 功能 | 状态 | 说明 |
|---|---|---|---|
| PA13 | SWDIO | 已验证 / 保留 | ST-Link 下载调试，必须保留 |
| PA14 | SWCLK | 已验证 / 保留 | ST-Link 下载调试，必须保留 |
| PC13 | 板载 LED | 已验证 | 低电平点亮，用于 P0 心跳闪烁 |
| PA0 | ADC1_IN0 | 已验证 | AD 四位按键模块，VCC 接 3.3V，GND 接 GND，AD 接 PA0 |
| PB5 | Buzzer | 已验证 | 有源蜂鸣器低电平触发：RESET 响，SET 不响 |
| PB0 | RGB_R | 已验证 | KY-016 RGB 红色通道 |
| PB1 | RGB_G | 已验证 | KY-016 RGB 绿色通道 |
| PB10 | RGB_B | 已验证 | KY-016 RGB 蓝色通道 |
| PB6 | I2C1_SCL / OLED | 已验证 | SSD1306 OLED，地址 0x3C |
| PB7 | I2C1_SDA / OLED | 已验证 | SSD1306 OLED，地址 0x3C |
| PB12 | FLAME_DO | 部分验证 | 3 针火焰传感器 DO；无火焰状态显示正常，真实触发待安全补测 |
| PB14 | MQ2_DO | 软件链路通过 | FT 数字输入；实物 DO 接入前需确认高电平不超过 5V，且 GPIO 输入禁用内部上下拉 |
| PB15 | PIR_DO | 已验证 | HC-SR501 OUT；PB15 最终方案通过 |

## 预留 / 待验证引脚

| 引脚 | 计划功能 | 状态 | 说明 |
|---|---|---|---|
| PA9 | USART1_TX | 已配置 / 待联调 | Stage 5 / Task 04：STM32 发送 `STM32_TEST` JSON 到 ESP32-CAM U0R/RX/GPIO3；尚未完成硬件联调验收 |
| PA10 | USART1_RX | 已配置 / 待联调 | Stage 5 / Task 04：USART1 RX 预留，当前主要验证 STM32 PA9 TX → ESP32-CAM RX |
| PA2 | USART2_TX | 暂时放弃 | Task 04 曾用于 STM32 → ESP32-CAM UART；逻辑分析仪未得到稳定 115200 UART 波形，阶段 5 暂不使用 |
| PA3 | USART2_RX | 暂时放弃 | Task 04 USART2 RX 预留同步放弃，阶段 5 改用 USART1 PA9/PA10 |
| PA1 | ADC1_IN1 | 预留 / 待验证 | 后续 MQ-2 AO 可选输入；5V 供电时 AO 接 ADC 前必须先分压到 VDDA/3.3V 范围 |
| PB13 | 暂不使用 | 原方案异常 | 原 PIR 输入链路不可靠，疑似排针/杜邦线/接触问题；不再作为 PIR 默认引脚 |
| PA6 | RELAY1_CTRL / 继电器控制 | 预留 / 待验证 | P0-05A，继电器必须经模块/驱动控制，不得 GPIO 直驱负载 |
| PA7 | FAN_CTRL / 风扇控制 | 已验证 | P0-05B 通过；L9110S 驱动模块，PA7 → INA，INB → GND，VCC → 5V；K2 ON / K4 OFF；测试完成后已拔线 |
| PB8 | PUMP_CTRL / 水泵控制 | 预留 / 待验证 | P0-05C，必须独立供电并经 MOS/驱动模块 |
| PB9 | SPARE_GPIO_OUT / 备用输出 | 备用 / 暂不使用 | 当前不参与 P0-05 执行器控制 |

## 电平与安全备注

| 项目 | 备注 |
|---|---|
| SWD | PA13/PA14 不得改作普通 GPIO |
| PC13 LED | 低电平点亮，驱动能力弱，只用于状态指示 |
| AD 按键 | 这是 AD 模拟按键模块，不是 PB12-PB15 四路独立按键 |
| 蜂鸣器 | 低电平触发，建议 `BUZZER_ON_LEVEL = GPIO_PIN_RESET`，`BUZZER_OFF_LEVEL = GPIO_PIN_SET`，PB5 初始电平 High |
| OLED | I2C1：PB6=SCL、PB7=SDA，地址 0x3C；已完成固定文本和 P0 调试页面 |
| MQ-2 | DO 使用 PB14，软件链路模拟通过；PB14 为 FT 数字输入，确认 DO 高电平不超过 5V 且 GPIO 输入禁用内部上下拉后可直连；AO 后续 PA1/ADC1_IN1，5V 供电时必须分压 |
| PIR | HC-SR501 最终使用 PB15；PB13 原方案不可靠，暂不使用 |
| 面包板供电 | 黑色面包板电源模块可通过跳帽输出 3.3V/5V 分轨；两侧正极不得直接相连，所有 GND 必须与 STM32 GND 共地 |
| ST-Link 供电 | 只适合 STM32 + 少量小功耗模块 bring-up；若 STM32 已由 Type-C 供电，ST-Link 只接 SWDIO/SWCLK/GND，不接 ST-Link 3.3V |
| 12V | 12V 适配器/电池不得直接接 STM32、OLED、PIR、MQ-2 |
| USART1 桥接 | Task 04 改用 PA9/PA10 为 3.3V TTL UART；PA9 接 ESP32-CAM U0R/RX/GPIO3 时必须共地，ESP32-CAM 继续由 USB 烧录底座供电，不得由 STM32/ST-Link 3.3V 供电 |
| USART2 桥接 | PA2/PA3 因逻辑分析仪未得到稳定 UART 波形，阶段 5 暂时放弃 |
