2549227674/stm32-ai-safety-monitor/tests/opi5-controller/2026-06-09_i2c_pca9685_detect.md

# OPi5 I2C PCA9685 检测测试

## 背景

OPi5 临时主控迁移第一步：确认 I2C 总线可用并检测 PCA9685 (0x40)。

## 接线

| OPi5 pin | 功能 | PCA9685 引脚 | 状态 |
|---|---|---|---|
| Pin 3 | SDA.5 (GPIO47) | SDA | 已接 |
| Pin 5 | SCL.5 (GPIO46) | SCL | 已接 |
| Pin 1 或 17 | 3.3V | VCC | 已接（LED 亮） |
| Pin 6/9/14 | GND | GND | 已接 |

## 命令

```bash
# 启用 I2C5 overlay
# orangepiEnv.txt: overlays=i2c5-m3
sudo reboot

# 扫描
sudo i2cdetect -y 5

# GPIO 验证
gpio readall  # pin 3=ALT9, pin 5=ALT9
```

## 原始输出

```
=== gpio readall (pin 3/5) ===
|   47 |   0 |    SDA.5 |   ALT9 | 1 |  3 |
|   46 |   1 |    SCL.5 |   ALT9 | 1 |  5 |

=== i2cdetect -y 5 ===
     0  1  2  3  4  5  6  7  8  9  a  b  c  d  e  f
00:                         -- -- -- -- -- -- -- --
...
40: -- -- -- -- -- -- -- -- -- -- -- -- -- -- -- --
...
```

## 观察现象

1. OPi5 I2C5 overlay 已正确加载：`/dev/i2c-5` 存在，I2C5 status = "okay"
2. Pin 3/5 已配置为 ALT9（I2C5 SDA/SCL）模式
3. SDA/SCL 空闲时均为高电平（1），总线未卡死
4. PCA9685 VCC LED 亮起（供电正常）
5. 测试了 3 个不同的 PCA9685 模块，均无响应
6. 更换杜邦线后仍无改善
7. `i2cdetect -y 5` 在所有地址（0x03-0x77）均未发现设备
8. 同时启用了 I2C1 overlay (pin 16/18)，也未检测到设备

## 已作废的判断

- ~~"手动拉低 pin 3 时 PCA9685 LED 无反应，因此 OPi5 pin3 到 PCA9685 SDA 物理连接不通"~~ — 此判断无效。
  - PCA9685 模块 LED 通常是 VCC 电源指示灯，不跟随 SDA/SCL 数据线变化。
  - pin 3 处于 I2C ALT9 复用状态时，通过 sysfs 导出为 GPIO 输出会破坏 I2C pinmux，不能作为 I2C 通断依据。

## 结论

**未通过：PCA9685 未在 OPi5 I2C5 总线上 ACK。**

当前可确认事实：

1. OPi5 系统环境已可用：Ubuntu 22.04 / kernel 6.1.99 / aarch64。
2. 26-pin 排针已确认。
3. `/boot/orangepiEnv.txt` 已启用 `i2c5-m3` overlay。
4. `/dev/i2c-5` 已出现。
5. `gpio readall` 显示 OPi5 pin 3 / pin 5 分别为 `SDA.5` / `SCL.5`，Mode 为 `ALT9`。
6. `i2cdetect -y 5` 未检测到 PCA9685 常见地址 `0x40`。
7. 3 个 PCA9685 模块均未 ACK。

当前疑点按优先级：

1. ~~OPi5 GND 与 PCA9685 GND 未真正共地~~ — OLED 共地正常，已排除。
2. ~~SDA/SCL 接线问题~~ — OLED 同线正常，已排除。
3. ~~I2C 上拉不足~~ — OLED 无需外部上拉即可工作，已排除。
4. ~~OPi5 排针 I2C 硬件问题~~ — OLED 0x3C 在 I2C1 (pin 16/18) 上正常响应，已排除。
5. **PCA9685 模块本身不可用** — 3 个模块均未 ACK，OLED 同线正常，确认为模块问题。

## 交叉验证结果

**OLED SSD1306 (0x3C) 在 I2C1 (pin 16/18) 上正常响应。**

```
=== i2cdetect -y 1 ===
30: -- -- -- -- -- -- -- -- -- -- -- -- 3c -- -- --
```

同时接 PCA9685 和 OLED 到 I2C1，只有 OLED 响应。

这排除了：
- OPi5 I2C 硬件问题
- 共地问题
- SDA/SCL 接线问题
- I2C 上拉不足
- 电平转换问题

**确认根因：3 个 PCA9685 模块均不可用。**

## 下一步

1. 购买确认可用的 PCA9685 模块（推荐 Adafruit 品牌或有售后的商家）。
2. 收到新模块后，先接 pin 16/18 (I2C1)，确认 0x40 出现后再接 pin 3/5 (I2C5)。
3. I2C1 (pin 16/18) 可作为主力 I2C 总线，OLED 已验证可用。

## 是否可写入 CANONICAL

部分可写入：

- 可写入：OPi5 I2C1 (pin 16/18) 已验证可用（OLED SSD1306 0x3C 正常响应）。
- 可写入：OPi5 I2C5 overlay 已启用、pin3/pin5 为 ALT9。
- 不可写入：PCA9685 已验证（3 个模块均未 ACK，需更换模块）。
