2549227674/stm32-ai-safety-monitor/tests/imx6ull/2026-06-06_i2c_pca9685_probe.md

# 2026-06-06 Task03-B I2C / PCA9685 地址验证记录

## 1. 分支与提交

- 分支：`migration/imx6ull-opi5-edge-ai`
- 当前基线提交：`7c76a92`
- 当前阶段：Task03-B I2C 与 PCA9685 地址验证

## 2. 设备树基线

- U-Boot `fdt_file`：`100ask_imx6ull-14x14.dtb`
- 板端 model：`Freescale i.MX6 ULL 14x14 EVK Board`
- 备用 custom dtb：`imx6ull-100ask-custom.dtb`

## 3. 接线说明

本轮只接 PCA9685 逻辑侧：

| PCA9685 | i.MX6ULL J5 |
|---|---|
| VCC | J5 pin 3 `VDD_3V3` |
| GND | J5 pin 2 `GND` |
| SDA | J5 pin 7 `I2C_SDA` |
| SCL | J5 pin 8 `I2C_SCL` |

明确未接：

- PCA9685 `V+` 舵机电源。
- MG90 舵机。
- MOS / 风扇 / 水泵。

## 4. 板端 I2C 工具检查

命令：

```bash
ssh root@192.168.137.110 "ls -l /dev/i2c-* 2>/dev/null || true; which i2cdetect || true"
```

输出：

```text
crw------- 1 root root 89, 0 Jan  1 00:00 /dev/i2c-0
crw------- 1 root root 89, 1 Jan  1 00:00 /dev/i2c-1
/usr/sbin/i2cdetect
```

结论：

| 项目 | 结果 |
|---|---|
| `/dev/i2c-*` | `/dev/i2c-0`、`/dev/i2c-1` |
| `i2cdetect` | 存在：`/usr/sbin/i2cdetect` |
| 扫描方式 | 直接使用 `i2cdetect -y <bus>` |
| `i2c_scan` | 未构建、未部署；板端已有 `i2cdetect`，不需要 fallback |

## 5. 扫描输出

### 5.1 `/dev/i2c-0`

命令：

```bash
ssh root@192.168.137.110 "i2cdetect -y 0"
```

输出：

```text
     0  1  2  3  4  5  6  7  8  9  a  b  c  d  e  f
00:          -- -- -- -- -- -- -- -- -- -- -- -- -- 
10: -- -- -- -- -- -- -- -- -- -- -- -- -- -- 1e -- 
20: -- -- -- -- -- -- -- -- -- -- -- -- -- -- -- -- 
30: -- -- -- -- -- -- -- -- -- -- -- -- -- -- -- -- 
40: 40 -- -- -- -- -- -- -- -- -- -- -- -- -- -- -- 
50: -- -- -- -- -- -- -- -- -- -- -- -- -- -- -- -- 
60: -- -- -- -- -- -- -- -- -- -- -- -- -- -- -- -- 
70: 70 -- -- -- -- -- --                         
```

### 5.2 `/dev/i2c-1`

命令：

```bash
ssh root@192.168.137.110 "i2cdetect -y 1"
```

输出：

```text
     0  1  2  3  4  5  6  7  8  9  a  b  c  d  e  f
00:          -- -- -- -- -- -- -- -- -- -- -- -- -- 
10: -- -- -- -- -- -- -- -- -- -- UU -- -- -- -- -- 
20: -- -- -- -- -- -- -- -- -- -- -- -- -- -- -- -- 
30: -- -- -- -- -- -- -- -- -- UU -- -- -- -- -- -- 
40: -- -- -- -- -- -- -- -- -- -- -- -- -- -- -- -- 
50: -- -- -- -- -- -- -- -- -- -- -- -- -- -- -- -- 
60: 60 -- -- -- -- -- -- -- -- -- -- -- -- -- -- -- 
70: -- -- -- -- -- -- -- --                         
```

## 6. PCA9685 地址结论

| 项目 | 结果 |
|---|---|
| PCA9685 所在 bus | `/dev/i2c-0` |
| PCA9685 地址 | `0x40` |
| 是否 ACK | 是，`i2cdetect -y 0` 显示 `40` |
| 其他观察 | 同一 bus 还显示 `0x70`；按本轮范围仅记录，不做寄存器或 PWM 操作 |

Task03-B I2C/PCA9685 地址验证通过。

## 7. 本轮边界

- 未接 PCA9685 `V+`。
- 未接 MG90 舵机。
- 未输出 PWM。
- 未配置 PCA9685 `MODE1`、`MODE2`、`PRESCALE` 或任何 PWM 寄存器。
- 未验证 MG90/MOS/V4L2/RKNN/Flask。
