2549227674/stm32-ai-safety-monitor/tests/imx6ull/2026-06-06_mos_skip_decision.md

# 2026-06-06 Task03-E MOS 低压负载验证跳过决策记录

## 1. 分支与提交

- 分支：`migration/imx6ull-opi5-edge-ai`
- 阶段：Task03-E MOS 低压负载验证

## 2. 决策

本轮跳过 MOS 低压负载验证，不焊接 XY-MOS 控制排针，不接 LED/风扇/水泵。

## 3. 原因

- XY-MOS 模块已识别，控制端 GND/TRIG-PWM 为圆孔焊盘，需要额外焊接排针或飞线。
- 项目当前已完成 GPIO 输入、I2C/PCA9685 地址、PCA9685 PWM 软件准备、MG90S 分时云台动作验证。
- 为保证进度，本轮把 MOS 作为扩展项保留，不作为当前 MVP 必需项。
- 当前演示执行器以 PCA9685 + MG90S 分时云台为主。

## 4. 状态

- XY-MOS 模块：已识别
- 控制端焊接：未实施
- MOS 测试程序（mos_output_test.c）：未编写
- LED/小风扇/水泵负载：未接入
- **不标记 MOS 已通过**

## 5. 后续

如时间允许，后续可补测：
- 焊接 XY-MOS 控制排针
- 编写 mos_output_test.c
- 先接 LED/小风扇验证开关
- 不接水泵（MVP 不需要）

## 6. 禁止事项确认

- 不写 MOS 已通过。
- 不新增未测试代码。
- 不接水泵。
- 不接 220V。
