2549227674/stm32-ai-safety-monitor/tests/imx6ull/2026-06-06_v4l2_capture.md

# Task04 V4L2 USB 摄像头抓拍测试记录

> 日期：2026-06-07
> 分支：migration/imx6ull-opi5-edge-ai
> 提交：d26a5c5 (task03: defer MOS load test as optional extension)

## 1. 硬件接入

- 摄像头：USB 免驱摄像头（UVC 1.00）
- USB ID：0bdc:8088 Y Media Corp.
- 接入位置：i.MX6ULL USB Host（USB Hub 1-1.3）

## 2. 板端识别

### lsusb 摘要

```
Bus 001 Device 008: ID 0bdc:8088 Y Media Corp.
```

### dmesg 识别摘要

```
uvcvideo: Found UVC 1.00 device USB Camera (0bdc:8088)
usbcore: registered new interface driver uvcvideo
USB Video Class driver (1.1.1)
```

注意：首次插入时出现多次 disconnect/reconnect（device number 4→5→6→7→8），最终稳定在 device 8。

### /dev/video* 节点

```
crw-rw---- 1 root video 81, 0 Jan  1 00:00 /dev/video0   ← pxp (i.MX6ULL Pixel Pipeline)
crw-rw---- 1 root video 81, 1 Jan  1 00:03 /dev/video1   ← USB Camera (UVC)
```

注意：`/dev/video0` 是 i.MX6ULL 的 pxp_v4l2 设备，不是摄像头。摄像头为 `/dev/video1`。

## 3. v4l2 工具情况

| 工具 | 状态 |
|---|---|
| v4l2-ctl | 存在 `/usr/bin/v4l2-ctl` |
| fswebcam | 不存在 |
| ffmpeg | 存在 `/usr/bin/ffmpeg` |
| yavta | 不存在 |

## 4. 摄像头格式

### 支持的 pixelformat

- MJPG (Motion-JPEG, compressed)

### 支持的分辨率（MJPG）

| 分辨率 | 帧率 |
|---|---|
| 1280x720 | 30 fps |
| 848x480 | 30 fps |
| 800x600 | 30 fps |
| 640x480 | 30 fps |
| 640x360 | 30 fps |
| 352x288 | 30 fps |
| 320x240 | 30 fps |
| 160x120 | 30 fps |

### 选用的格式

- pixelformat: MJPG
- 分辨率: 640x480

## 5. 抓图命令

```bash
mkdir -p /opt/edge-ai-safety-monitor/captures
v4l2-ctl -d /dev/video1 \
  --set-fmt-video=width=640,height=480,pixelformat=MJPG \
  --stream-mmap=3 \
  --stream-count=1 \
  --stream-to=/opt/edge-ai-safety-monitor/captures/task04_latest.jpg
```

## 6. 抓图结果

- 板端输出图片路径：`/opt/edge-ai-safety-monitor/captures/task04_latest.jpg`
- 回传到 WSL 路径：`tests/imx6ull/artifacts/2026-06-06_task04_latest.jpg`

### file 输出（板端）

```
/opt/edge-ai-safety-monitor/captures/task04_latest.jpg: JPEG image data, baseline, precision 8, 640x480, components 3
```

### file 输出（WSL 本地）

```
tests/imx6ull/artifacts/2026-06-06_task04_latest.jpg: JPEG image data, baseline, precision 8, 640x480, components 3
```

### ls -lh 输出

```
-rw------- 1 root root 7.5K Jan  1 00:06 /opt/edge-ai-safety-monitor/captures/task04_latest.jpg
-rw------- 1 qbz415 qbz415 7.5K Jun  7 09:53 tests/imx6ull/artifacts/2026-06-06_task04_latest.jpg
```

## 7. 验证结论

- 图片格式：JPEG image data, baseline, precision 8, 640x480, components 3
- 文件大小：7.5KB
- 是否可打开：已确认（file 命令识别为有效 JPEG）

## 8. 结论

**Task04 V4L2 USB 摄像头抓拍：已通过**

- USB 免驱摄像头（UVC 1.00）已在 i.MX6ULL 识别，设备节点 `/dev/video1`
- 摄像头支持 MJPG 格式，最高 1280x720@30fps
- 使用 v4l2-ctl 成功抓取 640x480 MJPEG 帧，保存为有效 .jpg 文件
- 图片已回传 WSL 并通过 file 命令确认为可打开的 JPEG 图片

## 9. 工具链说明

- 方案 A 成功：板端有 v4l2-ctl，摄像头支持 MJPEG，直接使用 v4l2-ctl 抓帧
- 未使用方案 B（自写 v4l2_capture.c）和方案 C（YUYV fallback）
