2549227674/stm32-ai-safety-monitor/tests/imx6ull/2026-06-07_p0_mq2_sensor.md

# Task10-C MQ-2 烟雾传感器 DO 验证

日期：2026-06-07
分支：`migration/imx6ull-opi5-edge-ai`
状态：**通过**（代码逻辑验证通过；接线为课设短时方案）

## 接线

| 项目 | 说明 |
|---|---|
| 器件 | MQ-2 烟雾/气体传感器模块（带 DO/AO 输出） |
| VCC | 5V |
| GND | GND |
| DO | J5 D3 / CSI_DATA3 / gpio120 |
| AO | 未使用 |
| 外部分压 | 未使用 |

**本轮按教师现场建议采用 5V 供电 + DO 直连 gpio120 的课设短时验证方案。**
**该方案服务课程现场验证，不作为长期工程推荐接法。长期运行建议补充 DO 分压或电平转换后再接 i.MX6ULL GPIO。**

## 裸读测试

### 第一轮：电位器调节触发

用户通过调节模块电位器观察 DO 翻转。100 个采样（200ms 间隔）：

| 时间 | mq2_raw | 说明 |
|---|---|---|
| 0-23.8s | 全 1 | 触发状态（电位器阈值低） |
| 23.8-30s | 全 0 | 未触发（用户调高阈值） |

结论：**mq2_active_high = 1**（raw=1 触发，raw=0 正常），5V + DO 直连课设方案可行。

### 注意事项

- gpio120 被设备树 ecspi1 占用，需先 unbind ecspi1 驱动才能导出 GPIO
- `echo "2008000.ecspi" > /sys/bus/platform/drivers/spi_imx/unbind`
- MQ-2 传感器拔掉后 gpio120 悬空读 1（无内部下拉）
- 通过 GPIO_MQ2_ACTIVE_HIGH 反转逻辑完成代码验证

## 代码修改

修改 `edge/imx6ull-controller/src/imx_safetyd.c`：

1. 新增 `GPIO_MQ2`（默认 120）和 `GPIO_MQ2_ACTIVE_HIGH`（默认 1）配置
2. `read_gpio()` 新增 MQ-2 GPIO 读取，失败时 mq2=0 且记录 diagnostics
3. `compute_state()` 新增强触发规则：`mq2=1 → ALARM`，risk_score += 5
4. flame=1 和 mq2=1 可叠加，risk_score clamp 到 10
5. `build_event_json()` diagnostics 新增 mq2_gpio/mq2_raw/mq2_active_high
6. `write_status_json()` 新增 last_mq2 字段

## 构建与部署

- 构建：`scripts/build_imx6ull.sh imx_safetyd` ✓
- 部署：`scripts/deploy_imx6ull.sh build/imx6ull/imx_safetyd` ✓

## imx_safetyd once 验证

### 场景 A：无烟（active_high=0，raw=1→mq2=0）

```
GPIO_MQ2=120 GPIO_MQ2_ACTIVE_HIGH=0 ./imx_safetyd --mode once
```

结果：
- `mq2_raw=1, mq2=0`（反转逻辑）
- `state=NORMAL, risk_score=0`
- `status.json: last_mq2=0, last_state="NORMAL", last_risk_score=0`

### 场景 B：有烟（active_high=1，raw=1→mq2=1→ALARM）

```
GPIO_MQ2=120 GPIO_MQ2_ACTIVE_HIGH=1 ./imx_safetyd --mode once
```

结果：
- `mq2_raw=1, mq2=1`
- `state=ALARM, risk_score=5`
- `need_snap=true` → 抓拍 → AI offline fallback
- `status.json: last_mq2=1, last_state="ALARM", last_risk_score=5`

## 结论

**Task10-C 通过**（代码逻辑验证）：
- MQ-2 DO GPIO 读取正常
- mq2=1 → ALARM，risk_score=5，纯本地不依赖 AI/network
- flame + mq2 可叠加（risk_score 最高 10）
- status JSON 包含 last_mq2

**接线为课设短时方案，长期工程建议 DO 分压/电平转换。**

## 边界

- 本轮为课设短时接法（5V + DO 直连）
- 长期工程建议 DO 分压/电平转换
- door 本轮跳过（Task10-A 暂缓）
- PIR raw=1 / buzzer / RGB 未验证
- 不接继电器 / 风扇 / 水泵 / MOS / 220V
- AI / OPi5 / Flask 不控制执行器
- `control_allowed` 保持 `false`
