2549227674/stm32-ai-safety-monitor/firmware/stm32/SafetyMonitor/Core/Inc/main.h

#define DOOR_MAG_DO_Pin GPIO_PIN_4
#define DOOR_MAG_DO_GPIO_Port GPIOA
#define DHT11_DATA_Pin GPIO_PIN_5
#define DHT11_DATA_GPIO_Port GPIOA
#define FAN_CTRL_Pin GPIO_PIN_7
#define FAN_CTRL_GPIO_Port GPIOA
#define RGB_R_Pin GPIO_PIN_0
#define RGB_R_GPIO_Port GPIOB
#define RGB_G_Pin GPIO_PIN_1
#define RGB_G_GPIO_Port GPIOB
#define RGB_B_Pin GPIO_PIN_10
#define RGB_B_GPIO_Port GPIOB
#define FLAME_DO_Pin GPIO_PIN_12
#define FLAME_DO_GPIO_Port GPIOB
#define MQ2_DO_Pin GPIO_PIN_14
#define MQ2_DO_GPIO_Port GPIOB
#define PIR_DO_Pin GPIO_PIN_15
#define PIR_DO_GPIO_Port GPIOB
#define BUZZER_Pin GPIO_PIN_5
#define BUZZER_GPIO_Port GPIOB
