2549227674/stm32-ai-safety-monitor/(commit log)

2026-06-01 Initial commit: STM32 AI safety monitor design documentation
    - 14 design documents covering architecture, hardware, software, protocols
    - CLAUDE.md with project guidance for Claude Code
    - Four-layer system architecture: STM32 local control → ESP32-CAM edge vision → Server/Web → Cloud AI
2026-06-02 docs: finalize stm32 hal bring-up workflow
2026-06-03 docs: 同步P0硬件Bring-up进度与OLED/PIR/MQ2记录
2026-06-04 refactor(stm32): split main into BSP modules
2026-06-04 chore(stm32): track CubeMX and Keil project support files
2026-06-04 p0-05b: add PA7 fan manual test logic
2026-06-04 docs: record P0-05B fan driver validation
2026-06-04 docs: update agent guidance for current P0 status
2026-06-04 docs: record ESP32-CAM HTTP test event validation
2026-06-04 Implement STM32 ESP32-CAM UART bridge
2026-06-04 Switch ESP32-CAM bridge to UART0 RX
2026-06-06 task03: prepare gpio input probe
2026-06-06 task03: record i2c pca9685 address probe
2026-06-06 task03: prepare pca9685 empty-load pwm
2026-06-06 task03: add time-sliced dual MG90 servo test and record pass
    PCA9685 CH0 (pan) and CH1 (tilt) servo test program uses time-sliced
    motion to avoid simultaneous peak current causing 5V supply droop.
    Each axis sweeps 1100→1900us independently while the other holds
    center. User confirmed both axes pass with no droop, jitter, or
    stall. Build script updated for pca9685_servo_test target.
    [pca9685_servo_test.c]
2026-06-06 task03: align MG90S time-sliced servo validation docs
    Unify servo model to MG90S across all Task03-D documentation. Fix stale
    pulse width references (old 1400/1600, 1450/1550) to match actual code
    (1100/1900us time-sliced). Add Task03 summary to AGENTS.md section 12.
    Note Task08 should use time-sliced pan-tilt strategy.
2026-06-06 task03: defer MOS load test as optional extension
    XY-MOS control pads require soldering headers. Current MVP does not
    depend on low-voltage load demonstration; PCA9685 + MG90S time-sliced
    pan-tilt serves as the primary actuator. MOS marked as deferred
    extension, not passed. Update docs/03, docs/11, AGENTS, DEVPLAN,
    and add skip decision record.
2026-06-07 task04: V4L2 USB camera capture pass
    USB UVC camera (0bdc:8088) recognized at /dev/video1 on i.MX6ULL.
    v4l2-ctl captures 640x480 MJPEG frame, saves valid JPEG (7.5KB).
    Update hardware verification table and task status across docs.
2026-06-07 task07-a: end-edge vertical slice with mock ai
    i.MX6ULL one-shot script: capture → POST OPi5 mock AI → assemble
    event → POST Flask. Dashboard /api/status/latest shows complete
    event with sensors/actuators/risk_score/vision/ai_result/latency_ms.
    control_allowed=false confirmed. Latency: capture=470ms ai=135ms
    post=146ms total=987ms. OPi5 unreachable degradation test passed.
2026-06-07 task08-a: add time-sliced pan-tilt scan demo
    PCA9685 + MG90S gimbal 3-point scan (pan 60/90/120°, tilt 90°).
    Each point: move → settle 800ms → V4L2 capture → POST OPi5 mock AI.
    Select highest risk_hint direction (tie→center). Flask event_id=1033
    includes vision.scan[3], vision.selected, ai_result, latency_ms.
    control_allowed=false confirmed. No抖动/卡死/压降/发热/掉线.
2026-06-07 task07-b: add imx safetyd lite gpio degradation spool
    Shell-based MVP control端 reads real PIR gpio117 via sysfs,
    generates NORMAL/VERIFY events with real sensor data.
    VERIFY path: capture → OPi5 mock AI → Flask POST.
    Clean OPi5 degradation: generates fresh ai_result.ok=false
    on failure (no stale AI reuse). Flask spool: saves to pending/
    on failure, flush mode resends to sent/. control_allowed=false.
2026-06-07 task07-c2: fix initd restart flow
2026-06-07 docs: record task07-d native c upgrade roadmap
    Record Task07-D split into D1 (libcurl), D2 (V4L2), D3 (modular C) as
    optional post-MVP enhancement items. No code changes — documentation only.
2026-06-07 task05-b: integrate qwen3-vl real ai service
    Qwen3-VL 2B deployed on OPi5 via rknn-llm C++ demo:
    - vision encoder (RKNN, 3 NPU cores) + LLM (RKLLM, W8A8)
    - single-shot C++ wrapper outputs JSON (ok/text/timing)
    - Python Flask service supports AI_BACKEND=mock|qwen3vl
    - risk_mapping with Chinese negation detection
    - /health and /api/infer/vision return real VLM results
    - vlm_result/explanation backward-compatible new fields
    - control_allowed=false maintained
    - mock regression passed
    - end-to-end inference ~13s (subprocess mode)
2026-06-07 task05-c: optimize qwen3vl worker and verify end-edge regression
    Qwen3-VL persistent worker (stdin/stdout JSON-line protocol):
    - models loaded once at startup, not per request
    - subsequent requests ~8.4s vs single-shot ~13s (~35% faster)
    - Python client manages worker subprocess lifecycle
    - QWEN3VL_MODE=worker|single_shot configurable
    - startup scripts for worker and Flask service
    i.MX end-edge regression verified:
    - imx_safetyd capture → OPi5 qwen3vl → Flask HTTP 201
    - risk_hint=0, vlm_result, control_allowed=false correct
    - risk_mapping negation detection extended
    [qwen3vl_backend.py, qwen3vl_worker.cpp, qwen3vl_worker_client.py, risk_mapping.py]
2026-06-07 docs: add task10 p0 sensor actuator integration plan
    - CANONICAL 0.6: P0 pin table (gpio117-124, PCA9685 servo) as single source of truth
    - docs/03: GPIO input/output tables with P0 actual values, level safety notes
    - docs/06: actuator strategy updated for P0 real driving, section 6.12 Task10
    - docs/07: section 7.10 P0 field usage, no schema changes
    - CLAUDE_CODE_TASK_10: new execution doc with 10-A..10-E vertical slices
    - AGENTS/CLAUDE/DEVPLAN/EXECUTION_GUIDE/TODO_INDEX: Task10 status and references
2026-06-07 docs: record task10-a door reed switch skip
    Task10-A deferred: bare read on gpio118 without external 10k pull-up
    did not produce stable 0/1. Internal 47K pull-up insufficient. User
    decided to skip door and proceed to Task10-B flame sensor.
    - imx_safetyd.c NOT modified; door logic unchanged
    - door status remains unverified / skipped
    - test record: tests/imx6ull/2026-06-07_p0_door_reed_switch_skip.md
2026-06-07 task10-b: verify flame sensor on gpio119
    - Flame sensor DO on gpio119 (J5 D2), 3.3V supply, active-high
    - Bare read confirmed stable 0/1 transitions with lighter
    - Added GPIO_FLAME (default 119) and GPIO_FLAME_ACTIVE_HIGH config
    - flame=1 triggers ALARM state with risk_score=6, purely local
    - Fixed AI offline fallback overriding local risk_score (was always 4)
    - Status JSON now includes last_flame field
    - door remains skipped (Task10-A), mq2/PIR/buzzer/RGB unverified
    - Test record: tests/imx6ull/2026-06-07_p0_flame_sensor.md
    [imx_safetyd.c]
2026-06-07 task10-c: verify mq2 sensor on gpio120
    - MQ-2 DO on gpio120 (J5 D3), 5V supply + direct connect (short-term course design)
    - Bare read confirmed stable 0/1 via potentiometer adjustment
    - Added GPIO_MQ2 (default 120) and GPIO_MQ2_ACTIVE_HIGH config
    - mq2=1 triggers ALARM state with risk_score=5, purely local
    - flame + mq2 scores can stack (risk_score clamped to 10)
    - Fixed docs/06 duplicate section numbering (6.12.1/6.12.2)
    - Test record: tests/imx6ull/2026-06-07_p0_mq2_sensor.md
    [imx_safetyd.c]
2026-06-07 docs: record task10-d pir evidence reuse
    Task10-D skipped retesting: PIR on gpio117 already verified in
    Task03-A (2026-06-06). Historical evidence: idle raw=0, trigger
    raw=1, stable 0/1 transitions. No board commands executed, no
    code changes.
2026-06-07 task10-e: verify buzzer and rgb outputs
    Add real output GPIO driving to imx_safetyd:
    - buzzer (gpio122): active low confirmed (0=on, 1=off)
    - RGB-R (gpio121): active high, red LED module/wiring TBD
    - RGB-G (gpio123): active high, green LED works
    - RGB-B (gpio124): active high, blue LED works
    State-driven outputs: NORMAL=green, VERIFY=blue,
    ALARM=red+buzzer, FAULT=red+blue+buzzer.
    All-off cleanup on exit and signal handler prevents
    buzzer from staying on.
    Evidence: tests/imx6ull/2026-06-07_p0_buzzer_rgb_outputs.md
    [imx_safetyd.c]
2026-06-07 task10-e2: add pca9685 rgb pwm backend
    Add PCA9685 CH2/CH3/CH4 PWM output for RGB status LEDs as a
    visual enhancement over GPIO. Buzzer remains on gpio122.
    New tool pca9685_set_pwm: standalone CLI to set any PCA9685
    channel to duty 0-4095, with automatic wake-from-sleep.
    Key findings during implementation:
    - PCA9685 enters SLEEP mode after pca9685_set_pose exits
    - MODE1 must be explicitly set to 0x20 (AI=1, SLEEP=0) for
    correct multi-byte I2C register writes
    - New RGB module: all three channels (R/G/B) confirmed working
    imx_safetyd now supports RGB_BACKEND=gpio|pca9685 (default gpio).
    Demo recommended: RGB_BACKEND=pca9685 for brighter LED output.
    Evidence: tests/imx6ull/2026-06-07_p0_r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
    [imx_safetyd.c, pca9685_set_pwm.c]
2026-06-07 docs: add task11 p1 expansion plan
    Add P1 expansion design (OLED/relay/SoC temp/pump) to canonical docs
    and create Task11 execution entry. Fan device removed per user decision.
2026-06-07 task11-a: bring up oled status screen
    OLED SSD1306 I2C status screen first slice:
    - bsp_oled_ssd1306.c/h: minimal SSD1306 driver (init, clear, draw_text)
    - font5x7.h: 5x7 ASCII font for 128x64 display
    - oled_test.c: standalone test tool (--bus /dev/i2c-0 --addr 0x3c)
    - imx_safetyd: OLED_ENABLE=0|1 optional integration, refreshes
    state/risk_score/sensors/actuators each loop; non-fatal on failure
    - build_imx6ull.sh: added oled_test and imx_safetyd OLED support
    Documentation cleanup:
    - Renamed Task11 file removing "fan" from filename
    - Removed fan/风扇 from Task11/P1 planning, CANONICAL 0.8,
    docs/02/03/06/07/08/10, AGENTS.md, CLAUDE.md, EXECUTION_GUIDE,
    TODO_INDEX, imx_safetyd.c event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
    [bsp_oled_ssd1306.c, bsp_oled_ssd1306.h, imx_safetyd.c, oled_test.c]
2026-06-07 task11-b: verify relay on pca9685 ch5
    KY-019 5V relay module on PCA9685 CH5:
    - Bare test: default OFF confirmed, active high (duty=4095 = ON)
    - imx_safetyd: RELAY_ENABLE=0|1, PCA9685_RELAY_CH=5,
    PCA9685_RELAY_ACTIVE_HIGH=1 env vars
    - ALARM → relay ON (buzzer + red LED + relay)
    - NORMAL/VERIFY/FAULT → relay OFF
    - all_off ensures relay released on exit
    - Event JSON actuators.relay uses real state
    - Non-fatal: relay write failure does not crash daemon
    [imx_safetyd.c]
2026-06-07 task11-c: add soc temperature health monitoring
    Read SoC internal temperature from /sys/class/thermal/thermal_zone0/temp,
    compute device_health=NORMAL|WARN based on configurable threshold,
    display on OLED, include in event/status JSON. soc_temp does NOT affect
    state machine, risk_score, relay, or pump.
2026-06-07 task11-d: verify pump water tank on pca9685 ch6
    CH6 drives dual-load (water pump + water gun emitter) via MOS.
    Active high (duty=4095 ON), default OFF. ALARM triggers pump=1,
    NORMAL/VERIFY/FAULT keep pump=0. all_off ensures CH6 duty=0 on exit.
    Short water demo passed. P1 extension complete.
    [imx_safetyd.c]
2026-06-08 task12: OPi5 USB WiFi rtl8188eu driver + Windows portproxy chain
    - OPi5 rtl8188eu out-of-tree driver compiled and loaded (0bda:0179)
    - WiFi interface wlx8420965bb9d8 confirmed working (scan + connect)
    - Windows portproxy: i.MX 192.168.137.1:18080 → OPi5 WiFi 10.96.98.38:8080
    - Full infer chain verified (health + AI infer via portproxy)
    - Wired path (10.0.1.120) retained as fallback
2026-06-08 task12-b: verify OPi5 WiFi after unplugging wired cable
    OPi5 wired cable removed. Windows portproxy chain still works:
    - Windows → OPi5 WiFi health: OK
    - Windows → 192.168.137.1:18080 health: OK
    - i.MX → portproxy health: OK
    - i.MX → AI infer via portproxy: OK (risk_hint=2, latency_ms=5)
    Old wired path (10.0.1.120) confirmed unreachable as expected.
2026-06-08 task12-c: sync docs for OPi5 WiFi + Windows portproxy network optimization
    - CANONICAL_DECISIONS: add 0.8 network topology + AI URL section
    - DEVPLAN: add Task12 completion status
    - CLAUDE_CODE_EXECUTION_GUIDE: add pre-demo network check commands
    - CLAUDE_CODE_TODO_INDEX: add Task12 completed entries + demo checklist
    - docs/03: add optional WiFi/portproxy network topology
    - docs/07: add AI URL examples (wired fallback + portproxy)
    - docs/11: add WiFi/portproxy test results + risk matrix
    - docs/13: add demo script for network optimization
2026-06-08 task12-d: i.MX6ULL onboard WiFi/4G lightweight diagnostic
    WiFi (RTL8723BU 0bda:b720):
    - Enumerated via USB Hub, driver loaded (8723bu.ko), wlan0/wlan1 present
    - Known wpa_supplicant compatibility issues, wifi-pwr disabled
    - Not used as project main link
    4G (EC20/ME909S):
    - No 4G module enumerated (no ttyUSB/cdc-wdm/wwan)
    - Board has expansion design but module not installed or not powered
    No system config changes made. Existing network unaffected.
2026-06-08 task12-e: i.MX6ULL onboard RTL8723BU WiFi successfully connected
    - Antenna attached, wlan0 scan successful
    - nl80211 driver mode: connected to hotspot, signal -45dBm, 72.2MBit/s
    - wext driver mode: connects then immediately disconnects (known issue)
    - DHCP obtained IP 10.96.98.109/24, internet accessible
    - Main link (eth0 → portproxy → OPi5 AI) unaffected
    - No recompilation of 8723bu.ko needed
    - Board WiFi available as backup connectivity
2026-06-08 task12-f: full wireless hotspot chain verified + WiFi auto-start templates
    Full wireless chain (all Ethernet unplugged):
    - i.MX (10.96.98.109) → OPi5 AI (10.96.98.38:8080): health + infer OK
    - i.MX → PC Flask (10.96.98.103:5000): health + status OK
    - PC → i.MX/OPi5 ping: OK
    - All via single phone hotspot, no portproxy needed
    Auto-start templates:
    - config/templates/wpa_supplicant_imx.conf.example
    - config/templates/S45wifi-client.example (init.d script, nl80211 driver)
    Fallback retained: wired + Windows portproxy
2026-06-08 task12-g: WiFi auto-start deployment + module reload fix
    - Deployed S45wifi-client to i.MX /etc/init.d/
    - Deployed wpa_supplicant_imx.conf to i.MX /etc/
    - Fixed RTL8723BU driver state issue: added rmmod/modprobe reload
    - i.MX proxy clean (no proxy config found)
    - Full wireless chain verified (i.MX → OPi5 AI + PC Flask)
    - OPi5 nmcli autoconnect pending manual config
    - Reboot regression pending manual verification
2026-06-08 task12-g2: complete OPi5 WiFi autoconnect + module auto-load config
    - OPi5 nmcli autoconnect=yes, retries=-1 configured
    - OPi5 /etc/modules-load.d/8188eu.conf created
    - OPi5 proxy verified clean
    - All via i.MX Python pty SSH (no manual intervention needed)
    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
2026-06-08 task12-g3: reboot regression passed - full wireless auto-start verified
    After reboot:
    - i.MX WiFi auto-connected (S45wifi-client, IP 10.96.98.109)
    - OPi5 WiFi auto-connected (nmcli autoconnect, IP 10.96.98.38)
    - OPi5 AI service running
    - Full chain: i.MX → OPi5 AI infer OK (latency_ms=6)
    - i.MX → PC Flask OK
    - No proxy on either device
    - No manual intervention needed
2026-06-08 task12-h: sync docs for full wireless network chain
    - CANONICAL_DECISIONS 0.8: full wireless as primary, portproxy/wired as fallback
    - DEVPLAN: Task12-A through Task12-H completed
    - CLAUDE_CODE_EXECUTION_GUIDE: updated network check for full wireless
    - CLAUDE_CODE_TODO_INDEX: updated demo checklist
    - docs/03: updated network topology section
    - docs/07: updated AI URL table (3 tiers)
    - docs/11: added full wireless risk matrix
    - docs/13: updated demo script for full wireless
    - docs/14: new final demo script and evidence pack
2026-06-08 task12-i: enable qwen3vl real ai autostart on opi5
    OPi5 AI service now defaults to Qwen3-VL real AI (not mock) with
    systemd autostart. Worker managed as subprocess by API service.
    Reboot regression passed: auto-start, health shows mode=qwen3vl,
    i.MX->OPi5 infer works via full wireless.
2026-06-08 task12-j: sync agent entry docs after qwen3vl autostart
    - Update CLAUDE.md and AGENTS.md sections 1/2/3/5/12/13
    - Add Task12-E/F/G/H/I to completed tasks
    - Add WiFi and Qwen3-VL autostart to hardware verification table
    - Update stable baseline to include full wireless + qwen3vl
    - Change env.example model paths to placeholders
    - Update primary goal to Task09
2026-06-08 task12-yolo: add yolo rknn backend, imx tracker, and spray double-confirm gate
    - OPi5: new yolo_rknn_backend.py with RKNN inference + mock fallback
    - OPi5: app.py adds yolo_rknn backend, /api/track/frame, /api/track/stream
    - i.MX: new imx_tracker.c for low-speed visual tracking (capture→OPi5→gimbal)
    - i.MX: imx_safetyd adds spray double-confirmation gate (local+vision)
    - Build: add imx_tracker target to build_imx6ull.sh
    - Both C binaries cross-compile clean; board-side test pending
2026-06-08 task12-hotfix: fix spray gate event json and safety timing
    - Hotfix A: event actuators.pump now reflects actual spray gate result
    - Hotfix B: matched_label outputs valid JSON (quoted string or null)
    - Hotfix C: visual state freshness window via monotonic_ms
    - Hotfix D: spray max duration (SPRAY_MAX_MS) and cooldown (SPRAY_COOLDOWN_MS)
    - Hotfix E: PCA9685 I2C file lock between tracker and safetyd
    - Hotfix F: AI curl timeout configurable (AI_CONNECT_TIMEOUT_SEC, AI_MAX_TIME_SEC)
    - Hotfix G: docs/07 sync for /api/track/frame, /api/track/stream, spray_confirm
    [imx_safetyd.c, imx_tracker.c]
2026-06-09 task13: OPi5 controller migration - GPIO/I2C/PWM verified
    i.MX6ULL 故障后，将本地安全主控迁移到 OPi5 临时主控。
    已完成：
    - OPi5 I2C5 overlay 启用，OLED (0x3C) + MPU6050 (0x68) 可用
    - GPIO 输入验证：火焰 (GPIO28, active LOW)、PIR (GPIO139, active HIGH)、MQ-2 (GPIO49, active LOW)
    - GPIO 输出验证：蜂鸣器 (GPIO35, active LOW)、RGB (GPIO48/50/52)、水枪 MOS (GPIO138)
    - PWM 舵机验证：pin 7 (PWM15, pwmchip4), 80-90 度有效范围
    - PCA9685 确认为模块问题（4 个均未 ACK），改用 GPIO/PWM 直控
    - opi5_safetyd.c 引脚配置更新为实测值
    - 文档同步：CANONICAL_DECISIONS、README、docs/04/06/13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
    [bsp_oled_ssd1306.c, bsp_oled_ssd1306.h, opi5_safetyd.c, pca9685_set_pwm.c]
2026-06-09 task13: fix imx_safetyd pca9685 lock error handling
    Add spray_decision field and lock acquire error handling to imx_safetyd.c.
    [imx_safetyd.c]
2026-06-09 docs: align OPi5 temporary controller architecture
    Unify documentation to reflect OPi5 as current main controller
    (opi5_safetyd + opi5_ai_service), with i.MX6ULL framed as
    historical validation evidence. Update README, DEVPLAN, docs/04,
    docs/06, docs/13 to remove residual "i.MX current mainline"
    contradictions.
2026-06-09 docs: fix residual i.MX GPIO pins in docs/06 section 6.7
    Update buzzer/RGB pin references from i.MX gpio122/121/123/124
    to OPi5 GPIO35/48/50/52, with historical note.
2026-06-09 docs: fix docs/06 6.7 actuator description to OPi5 GPIO
    Replace residual i.MX GPIO pin references with OPi5 Task13
    verified pins and add PCA9685 unavailable note.
2026-06-09 task14: backend device API + OPi5 device-agent
    - Backend: add 13 new API endpoints (heartbeat, devices, telemetry, AI observations, thresholds, alerts, video proxy, SSE)
    - Database: add 7 new tables (device_status, telemetry_samples/batches, ai_observations, thresholds, alerts)
    - OPi5 device-agent: video stream, mock sensors, heartbeat, telemetry batch, AI observation
    - Systemd templates for device-agent deployment
    - Update OPi5 WiFi IP to 10.96.98.38 in CANONICAL_DECISIONS.md
2026-06-09 task15: add email notification with cooldown and logging
    - Add email_notifier.py module with SMTP support
    - Environment variables: SMTP_HOST, SMTP_PORT, SMTP_USER, SMTP_PASSWORD, SMTP_FROM, ALERT_EMAIL_TO, ALERT_EMAIL_ENABLED, ALERT_EMAIL_COOLDOWN_SECONDS
    - New APIs: GET/PUT /api/notification/settings, POST /api/notification/test-email, GET /api/notification/logs
    - Auto-trigger email on telemetry threshold alerts and AI risk hints
    - Cooldown prevents spam (default 300s)
    - Delivery logged to notification_log table
    [app.py]
2026-06-10 frontend: port Claude Design edge console
    - React + Vite multi-page console with dark industrial theme
    - 8 pages: overview, live, AI, sensors, thresholds, alerts, notify, device
    - 3D isometric digital twin scene
    - SVG charts (TimeChart, Spark, BinaryStrip, TimingBar)
    - Real data priority: auto-detect devices via /api/devices, fallback to mock
    - SSE subscription for real-time events when device is online
    - Mock data engine for offline preview (normal/alarm/degraded/offline scenarios)
    - Corrected factual references: OPi5/RK3588S instead of i.MX6ULL
2026-06-10 frontend: fix real data integration and persistence
    - VideoSurface: real mode uses /api/video/stream MJPEG, mock mode uses
    image-slot placeholder; videoOnline/videoError/cameraStatus states
    - systemStatus: real mode checks device.online, camera, video status
    instead of only sim.scenario
    - AI display: stale observations (>90s) show "暂无有效AI观察" in real
    mode; mock text explicitly tagged with [mock]
    - Data normalization: add normalizeDevice/normalizeAlert/normalizeObservation/
    normalizePoint to handle backend ISO timestamps and nested structures
    - Device selection: only online=true devices enter real mode
    - Thresholds: real API calls (GET/PUT /api/thresholds); text updated to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
2026-06-10 docs: align all documentation to OPi5 mainline, archive i.MX/STM32/ESP32
    Rewrite root docs (CANONICAL_DECISIONS, README, CLAUDE, AGENTS,
    EXECUTION_GUIDE, DEVPLAN, docs/00) to declare OPi5 as the current
    demo mainline. Archive i.MX6ULL task files (Task02/03/04/07/08/10/11)
    to docs/archive/2026-imx6ull-stage/tasks/ with stubs in root. Rename
    docs/03 and docs/08 to remove iMX6ULL from filenames. Add OPi5
    hardware reference docs and full API contract to docs/07.
2026-06-10 docs: rewrite all docs to OPi5 mainline, remove i.MX as current controller
    Phase 2 docs alignment: rewrite docs/00-14 body to OPi5 single-board
    architecture (safetyd + AI + device-agent + Flask/React). Key changes:
    - docs/01/02/03/08/11/12/14 fully rewritten to OPi5 mainline
    - docs/04/06/09 compressed historical i.MX, added device-agent
    - docs/07 fixed duplicate numbering, added device-agent contracts
    - docs/10 fixed stale i.MX reference
    - archive README populated with docs/hardware subdirectories
2026-06-10 docs: targeted fixes for contract payloads, TODO index, and MVP standards
    - docs/05: rewrite MVP to OPi5 safetyd + device-agent + Flask/React
    - docs/07: fix telemetry batch (window/samples/summary), heartbeat
    (agent_version/ip/uptime_s/health/ai), AI observation (model as
    object), video proxy (OPI5_DEVICE_AGENT_URL primary)
    - docs/08: fix video proxy to note OPI5_DEVICE_AGENT_URL dependency
    - docs/14: fix device-agent health check port 5000 → 8090
    - CLAUDE_CODE_TODO_INDEX: move old to archive, create lightweight OPi5-only version
    - docs/00: add docs/05 to doc map
2026-06-10 fix: align device-agent/backend/frontend fields for camera, telemetry, and notifications
    - device-agent: add get_status() to VideoCapture, heartbeat includes camera/video fields
    - device-agent: nest device metrics under sample["device"] in telemetry_loop
    - backend: _get_device_agent_url infers from ip+port when agent_url missing
    - backend: add metric aliases (cpu_temp_c→device.cpu_temp_c, pir→safety.pir, etc.)
    - backend: video proxy returns 503 JSON (not fake JPEG) when agent unreachable
    - backend: email dedupe_key for cooldown, _save_config returns success/failure
    - frontend: normalizeDevice handles nested heartbeat with camera_status/video_mode
    - frontend: VideoSurface shows MOCK VIDEO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
    [app.py, video.py]
2026-06-10 hotfix: notifier scope, agent_url unknown, minimal JPEG, seed video semantics
    - backend: pass notifier to _check_telemetry_alerts/_check_ai_alert (no NameError)
    - backend: _get_device_agent_url skips "unknown" host in agent_url and ip
    - device-agent: skip agent_url when ip is unknown (no http://unknown:8090)
    - device-agent: _minimal_jpeg returns valid JPEG binary, not raw text
    - seed: video_available=false, note about needing mock agent for video stream
    [app.py, video.py]
2026-06-10 docs: sync status after field alignment and video hotfix
    - docs/07: heartbeat fields moved from "pending" to "implemented" with full example
    - docs/07: telemetry sample uses device.* nested structure, added metric alias table
    - docs/07: notification section documents dedupe_key and cooldown mechanism
    - docs/08: video proxy documents agent_url resolution and 503 on unknown
    - docs/08: frontend display table maps camera_status/video_mode to UI states
    - TODO index: 4 items moved from OPEN to COMPLETED
    - DEVPLAN: field alignment, frontend, seed tasks moved to Done
    - CANONICAL_DECISIONS: added confirmed contract details section
2026-06-10 task: switch I2C from I2C5 (pin 3/5) to I2C1 (pin 16/18) for OLED+MPU6050
    I2C5 bus on pin 3/5 cannot detect external I2C devices despite correct
    overlay (i2c5-m3) and ALT9 pinmux. Root cause not fully determined.
    OLED (0x3C) and MPU6050 (0x68) verified working on I2C1 (pin 16/18).
    Changes:
    - opi5_safetyd.c: DEFAULT_OLED_BUS / DEFAULT_PCA9685_BUS → /dev/i2c-1
    - opi5-safetyd.example.env: OLED_BUS → /dev/i2c-1
    - All docs updated: I2C5→I2C1, pin 3/5 marked free, pin 16/18 marked I2C1
    - Pinmap table rewritten with correct I2C1 entries
    - Added regression test evidence from OPi5 real hardware
    [opi5_safetyd.c]
2026-06-10 deploy: migrate frontend and backend to OPi5 all-in-one runtime
    - Update env templates: BACKEND_URL from PC_IP to 127.0.0.1 (all-in-one)
    - Update safetyd env: BACKEND_URL from PC to localhost
    - Add deploy/systemd/ with 4 service files (backend, device-agent, safetyd, ai)
    - All services share unified env: /etc/edge-ai-safety-monitor.env
    - Add config/opi5-all-in-one.env.example with all service ports
    - Add scripts/deploy_opi5_all_in_one.sh for one-command setup
    - Add docs/deployment/opi5_all_in_one_deploy.md
    - Lower video defaults: 12fps/82quality -> 10fps/70quality
2026-06-10 deploy: fix OPi5 all-in-one systemd paths and SMTP config notes
    - Fix symlink layout: use edge/opi5-* prefix for device-agent, ai,
    controller; add server/frontend; safetyd binary under build/opi5-controller
    - Fix opi5-device-agent WorkingDirectory to include edge/ prefix
    - Fix opi5-ai-qwen3vl WorkingDirectory to include edge/ and /service
    - Fix opi5-safetyd ExecStart to use build/opi5-controller/opi5_safetyd
    - Add SMTP notification_config.json handling hint to deploy script
    - Add notification_config.json notes to deployment docs
2026-06-10 fix: video stream frame pacing and default 30fps
    - Add time.sleep(1.0 / fps) in MJPEG stream generator to prevent
    burst-sending duplicate frames, fixing stuttering playback
    - Raise default VIDEO_FPS from 10 to 30 (camera supports it)
    [app.py]
2026-06-10 fix: reduce video stream proxy latency with larger chunk size
    Use 64KB chunks instead of 4KB to reduce per-frame transfer overhead
    through the backend MJPEG proxy.
    [app.py]
2026-06-10 fix: reduce OpenCV capture buffer to minimize stream latency
    Set CAP_PROP_BUFFERSIZE=1 so each read() returns the newest frame
    instead of an old buffered one, reducing inherent camera-to-display
    delay by ~100-170ms.
    [video.py]
2026-06-10 fix: video stream direct-connect to device-agent, bypass backend proxy
    When agent_url is available, the frontend streams video directly from
    device-agent (port 8090) instead of proxying through the backend
    (port 5000), reducing latency by one HTTP hop.
2026-06-10 fix: remove redundant sleep from video stream generator
    The capture loop already paces frames at the configured FPS.
    Adding sleep(1/fps) in the generator doubled the per-frame delay,
    halving effective frame rate. Remove it so the generator yields
    frames as fast as the capture thread produces them.
    [app.py]
2026-06-10 fix: raw MJPG capture, condition-based frame sync, 20fps target
    - Read raw MJPG bytes from camera (CAP_PROP_CONVERT_RGB=0), skip
    redundant BGR decode + JPEG re-encode, saving ~2.7ms per frame
    - Use threading.Condition + frame version counter so stream generator
    blocks until a genuinely new frame arrives (no duplicate frames)
    - Set default VIDEO_FPS=20 to match camera hardware actual throughput
    [app.py, video.py]
2026-06-11 video: reduce MJPEG stream latency on OPi5 all-in-one
    - Force FOURCC=MJPG in OpenCV capture, read back actual negotiated values
    - Remove sleep(1/fps) from capture loop; cap.read() already blocks at camera rate
    - Keep CONVERT_RGB=0 to avoid OpenCV decode→re-encode overhead
    - Add _frame_to_jpeg() with ndarray fallback via cv2.imencode
    - Add live diagnostics: frames_captured, measured_fps (5s rolling), actual_fourcc
    - Add Content-Length per frame and Cache-Control/X-Accel-Buffering headers
    - Reduce backend proxy chunk_size from 65536 to 4096
    - Unify frontend video path to always use Flask proxy (not agent_url)
    - Remove redundant HEAD snapshot polling; video status comes from heartbeat
    - Add s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
    [app.py, video.py]
2026-06-11 ai: enable real Qwen3-VL 2B on OPi5 all-in-one
    - Fix qwen3vl_worker_client to read QWEN3VL_BINARY from env
    (was hardcoded to old path, causing worker binary not found)
    - Add AI_BACKEND/QWEN3VL_* config to opi5-all-in-one.env.example
    Tested on OPi5: /health mode=qwen3vl, model_ready=true,
    inference returns real scene analysis from camera feed.
    [qwen3vl_worker_client.py]
2026-06-11 frontend: add realtime sensor state stream for OPi5 testing
    Backend:
    - Add _fetch_realtime() to pull fresh data from device-agent /api/status
    - SSE /api/stream/events now includes realtime field with live sensors,
    device metrics, camera, and fetch_latency_ms
    - Add agent URL cache to avoid DB lookup every second
    Frontend:
    - processSSETick() now uses realtime channel for sensor values
    (pir, flame, mq2, risk, vib, cpu_temp, mem_used, temp, hum, lux)
    - Falls back to latest_event.sensors only when realtime unavailable
    - Slow telemetry series polling from 10s to 30s (history supplement)
    - Remove redundant /api/devices polling from startPolling()
    - Add realtimeAge() accessor for data staleness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
    [app.py]
2026-06-11 backend: cache realtime SSE status to avoid video stream contention
    - Replace per-request _fetch_realtime() with _RealtimeCache class
    - Background thread fetches device-agent /api/status once per second
    - SSE clients read from cache (non-blocking, <1ms read)
    - Add REALTIME_SSE_ENABLED and REALTIME_SSE_INTERVAL_SEC env vars
    - Add age_ms to realtime field for frontend staleness detection
    - Reduce fetch timeout from 2s to 0.5s
    - Wrap VideoSurface img in React.memo to prevent re-mount on sensor updates
    - Add import os/time at module level
    Baseline: agent ~20fps, backend ~26fps (no browser)
    [app.py]
2026-06-11 frontend: handle ISO timestamps in timeAgo and fmtTime
    - Add toSec() helper: supports number, numeric string, ISO string, null
    - timeAgo() now parses ISO strings like "2026-06-11T08:49:28+00:00"
    - fmtTime() also uses toSec() for consistent parsing
    - Returns "—" instead of "NaNh 前" for invalid/null timestamps
2026-06-11 frontend: hydrate dashboard history from backend database
    - Add list_ai_observations() to database.py (device_id, limit, ORDER BY id DESC)
    - Add GET /api/ai/observations?device_id=&limit= endpoint
    - Enhance GET /api/events to support device_id filter and limit up to 500
    - Update parse_limit() to accept custom max_limit parameter
    Frontend loadInitialData():
    - Load 100 recent events → sim.events (deduped by event_id)
    - Load 24 recent AI observations → sim.ai (deduped by id)
    - Load 10min telemetry series for risk, cpu_temp, vib, pir, flame, mq2, smoke
    - Keep existing device, thresholds, alerts, notification loads
    After refresh, charts show last 10min history, event stream shows r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
2026-06-11 frontend: clarify realtime sensor data sources
    Add sensors_source diagnostic field from device-agent through backend
    SSE to frontend, so each sensor card shows its actual data origin:
    - Safety (PIR/Flame/MQ-2): "safetyd" vs "fallback mock" vs stale/missing
    - MPU-6500: "mock 数据 · 未接真实 MPU" label; ax/ay/az pushed via SSE
    - DHT11: always "外接 MCU 预留 · mock 数据" in real mode
    - Systemd unknown → "unknown / service not found or not running"
    with diagnostic systemctl command hint
    - Backend _RealtimeCache now forwards sensors_source, accel_x/y/z,
    and warnings from device-agent /api/status
    - Added 传感器数据源诊断指南.md with diagnostic commands
    Co-Authored-B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
    [app.py, mock_sensors.py]
2026-06-11 device-agent: support both safetyd status file formats
    safetyd_status.json on OPi5 uses flat keys (last_pir/last_flame/last_mq2)
    while newer code expects nested sensors.pir. Now tries both:
    1. data["sensors"]["pir"] (new format)
    2. data["last_pir"] (OPi5 current format)
    Without this fix PIR/Flame/MQ-2 always read as 0 on OPi5.
    [mock_sensors.py]
2026-06-11 device-agent: real MPU-6500 I2C reading, replace mock with live sensor
    Add mpu6500_reader.py using smbus2 to read accelerometer/gyro from
    MPU-6500 at /dev/i2c-1 address 0x68. mock_sensors.py now tries real
    I2C first and falls back to mock sine-wave if unavailable.
    sensors_source.mpu6500 reports "real_i2c" when hardware is connected,
    "mock" when falling back. Frontend labels updated accordingly:
    - "I²C · /dev/i2c-1 · 0x68 · 真实 MPU-6500" for real data
    - "mock 数据 · 未接真实 MPU-6500" for fallback
    Requires: pip install smbus2, user in i2c group.
    [mock_sensors.py, mpu6500_reader.py]
2026-06-11 device-agent: add DHT11 temperature/humidity sensor support
    Add dht11_reader.py (subprocess wrapper) and tools/dht11_read.py
    (lgpio-based bit-bang reader) for real DHT11 sensor on GPIO 148
    (pin 22). DHT11 is dormant by default (DHT11_ENABLE=0).
    When enabled, mock_sensors.py reads real temp/humidity and reports
    sensors_source.env = "real_dht11_gpio". On failure, falls back to
    "dht11_error_fallback_mock". When disabled, stays "mock".
    Frontend labels updated for all three env states.
    Recommended wiring:
    VCC → 3.3V, GND → GND, DATA → GPIO148/pin22 + 4.7k pull-up to 3.3V
    [dht11_read.c, dht11_read.py, dht11_reader.py, mock_sensors.py]
2026-06-11 tools: improve DHT11 reader diagnostics and response handling
    Add proper DHT11 response signal detection (wait for LOW then HIGH
    before reading 40 data bits). Add --diag flag and clear error message
    when DATA line is stuck LOW (missing pull-up resistor).
    [dht11_read.py]
2026-06-11 feat(opi5): add timed servo patrol and flame-triggered water gun control
    - Servo patrol: configurable interval (default 30s), multi-angle sweep
    (60/90/120°), per-angle capture + AI inference via /api/infer/vision,
    patrol status JSON at run/opi5_patrol_status.json, backend event
    posting with source=patrol, frontend Alerts/Overview display
    - Water gun: GPIO138 direct control on flame sensor trigger, max 800ms
    activation, 5s cooldown, disabled by default (WATER_GUN_ON_FLAME_ENABLE)
    - Fix: backend normalize_event now preserves payload source field instead
    of overwriting with request IP address
    - Both features default OFF, require explicit env enable
    - Does not touch MPU/OLED/video/sta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
    [app.py, opi5_safetyd.c]
2026-06-11 fix(opi5): servo drift fix, patrol sweep redesign, water gun in normal loop
    - Servo: period set once at init, only duty_cycle updated on angle
    change to eliminate PWM glitch that caused drift
    - Patrol: sweep sequence center→left→center→right→center with 2s
    capture settle, batch AI call with all photos + sensor summary
    - Water gun: check flame sensor every 2s cycle (not just patrol),
    immediate trigger when flame detected
    - WatchdogSec increased to 120s for patrol cycles
    - Add PATROL_SETTLE_CAPTURE_MS config (default 2000ms)
    [opi5_safetyd.c]
2026-06-12 fix(ai): read QWEN3VL_BINARY env var in worker client
    The worker client had a hardcoded path to a non-existent binary.
    Now reads QWEN3VL_BINARY env var (same as single_shot mode).
    [qwen3vl_worker_client.py]
