2549227674/stm32-ai-safety-monitor/(notices)

Notices in the files:
firmware/stm32/SafetyMonitor/Core/Inc/main.h:
Copyright (c) 2026 STMicroelectronics.
All rights reserved.
This software is licensed under terms that can be found in the LICENSE file
